kopavel/KiCadLogicalSchemeSimulator/stuff/examples/README.md

## Examples

Here is some schemas Netlist examples:

- [Clock](clock/README.md) - Simple 24h clock.
- [Counters](counters/README.md) - simple chain for counters and LEDs
- [Z80](z80/README.md) - Zilog Z80 based schema.
- [TRS80](trs80/README.md) - Stripped TRS80-I schema.
