kopavel/KiCadLogicalSchemeSimulator/stuff/examples/clock/README.md

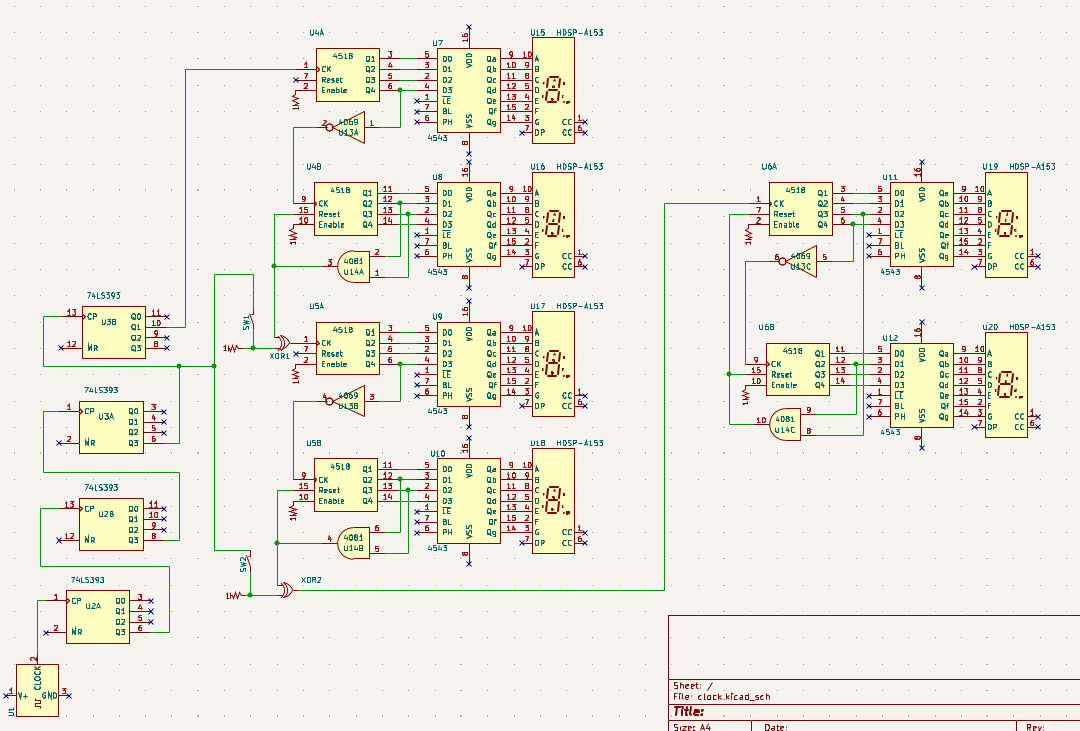
[picture p4: stuff/examples/clock/img_1.png]


**24h clock with time adjustment**

Trivial digital clock with 7 segment LED display.
Has time adjustment capability fot minutes and hours.

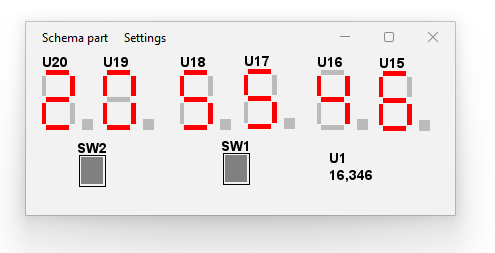
[picture p5: stuff/examples/clock/img.png]


For start use clock gradle task

```
./gradlew clock
```
