kopavel/KiCadLogicalSchemeSimulator/stuff/examples/counters/img/KiCad.png

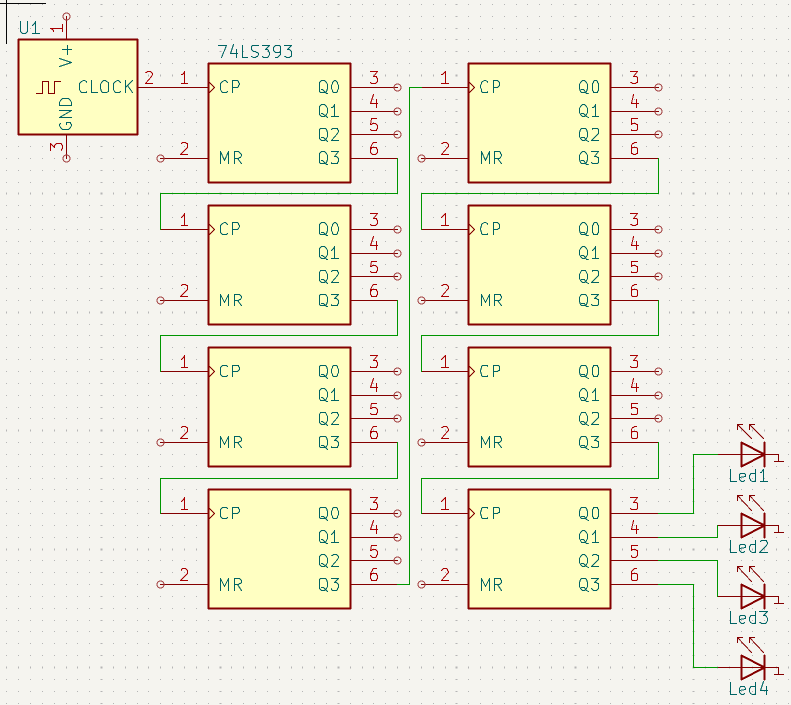
stuff/examples/counters/img/KiCad.png
