kopavel/KiCadLogicalSchemeSimulator/schemaParts/README.md

## Schema parts

For implementing or extending schema parts, see
[Schema Part Design](DESIGN_SchemaPart.md).

Some schema parts are interactive. Simulator create “representation” of that part on a “desc”.  
They can be drugged across the desk and allow you to arrange it layout to complete device look.  
Layout a stored at application exit in a file near '.net' or in KiKad project (if simulator started directly from iKiCad) with extension
`.sym_layout`.  
Some interactive parts has additional interfaces/functionality if you click on it.

* [AndGate](and/README.md) — Logical AND gate.
* [Bipolar Transistor](transistor/README.md) — Bipolar transistor.
* [Buffer](buffer/README.md) — Buffer or latch.
* [BusDriver](busDriver/README.md) — Bus driver/buffer.
* [Counter](counter/README.md) — Binary counter.
* [DCounter](dCounter/README.md) — Binary/decimal counter.
* [DcTrigger](dcTrigger/README.md) — DC-trigger with R and S inputs.
* [Decoder](decoder/README.md) — Binary decoder.
* [Diode](diode/README.md) — Diode.
* [DipSwitch](dipSwitch/README.md) — Net file filter for Dip switch behavior.
* [Display](display/README.md) — Monochrome display.
* [JkTrigger](jkTrigger/README.md) — JK trigger.
* [Keyboard](keyboard/README.md) — Matrix of key.
* [LedIndicatot](led/LedIndicator.md) — LED indicator.
* [Led](led/Led.md) — LED.
* [Led16SegmentDisplay](led16SegmentDisplay/README.md) — 16 segment LED display.
* [Led7SegmentDisplay](led7SegmentDisplay/README.md) — 7 segment LED display.
* [MaskedMultiplexer]( multiplexer/MaskedMultiplexer.md) — Multiplexer with a defined amount outputs and ways with masking inputs.
* [Mos6502](mos6502/README.md) - Mos 6502 CPU.
* [Mos6532](mos6532/README.md) - Mos 6532 RIOT.
* [MultiOutDecoder](decoder/MultiOutDecoder.md) — Decoder with multiple output pin groups.
* [MultiPartConter](counter/MultiPartCounter.md) — Multipart binary counter.
* [Multiplexer](multiplexer/README.md) — Multiplexer with a defined amount outputs and ways.
* [OrGate](or/README.md) — Logical OR gate.
* [Oscillator](oscillator/README.md) — Oscillator with various modes of operation and oscilloscope.
* [Power](power/README.md) — Static output, useful for a pull-up/pull-down resistors.
* [Ram](ram/README.md) — Static RAM.
* [Repeater](repeater/README.md) — Single bit buffer/inverter.
* [Resister](resister/README.md) — Resister.
* [RingCounter](ringCounter/README.md) — Ring counter.
* [Rom](rom/README.md) — ROM.
* [SdRam](sdram/README.md) — Dynamic RAM.
* [Shifter](shifter/README.md) — Bit shifter.
* [SingleBitBuffer](buffer/SingleBitBuffer.md) — Single bit Buffer or Latch.
* [SingleBitRam](ram/SingleBitRam.md) — Single bit Dynamic RAM.
* [SingleBitSdRam](sdram/SingleBitSdRam.md) — Single bit Dynamic RAM.
* [SingleOutShifter](shifter/SingleOutShifter.md) — Bit shifter with single bit output.
* [StateMachine](stateMachine/README.md) — Logical state machine.
* [Switch](switch/README.md) — Interactive “normally opened” switch.
* [XorGate](xor/README.md) — Logical XOR gate.
* [Z80Cpu](z80/README.md) — Zilog Z80 CPU.

* more follows …
