kopavel/KiCadLogicalSchemeSimulator/schemaParts/dipSwitch/README.md

## DipSwitch

Net file filter. Implement dip switch behavior.  
Do nothing by himself.

### Pins

#### Input names:

- none

#### Output names:

- none

### Parameters
- 

- none

#### Mandatory parameters:

- none

#### Optional parameters:

- `on` If provided - filter merge two schema nets together.
