kopavel/KiCadLogicalSchemeSimulator/schemaParts/resister/README.md

## Resister

Implements resister.

### Pins

- `IN1`, `IN2`

### Parameters

- none
