kopavel/KiCadLogicalSchemeSimulator/schemaParts/diode/README.md

## Diode

Implements diode.

### Pins

- `A`- Anode
- `K`- Cathode

### Parameters

- none
