kopavel/KiCadLogicalSchemeSimulator/schemaParts/switch/README.md

## Switch

Interactive initially opened toggle switch.

### Pins

- `IN1`,`IN2`- switch pins

### Parameters

- none
