kopavel/KiCadLogicalSchemeSimulator/schemaParts/repeater/README.md

## REPEATER

Buffer/inverter.

### Pins

#### Input names:

- `IN`- Input.

#### Output names:

- `OUT`- Output.

### Parameters

#### Mandatory parameters:

- none

#### Optional parameters:

- `reverse`- output reversed.
- `openCollector`- open collector output.
- `openEmitter`- open emitter output.

### Example

NOT element: `reverse`
