kopavel/KiCadLogicalSchemeSimulator/schemaParts/xor/README.md

## Logical XOR gate

### Pins

#### Input names:

- `IN0`, `IN1`- gate inputs.

#### Output names:

- `OUT`- Output

### Parameters

#### Mandatory parameters:

- none

#### Optional parameters:

- `reverse`- output reversed, resulting in a NXOR gate.
- `openCollector`- openCollector output

### Example

NXOR gate: `reverse`.
