kopavel/KiCadLogicalSchemeSimulator/schemaParts/or/README.md

## Logical OR gate

### Pins

#### Input names:

- `INx`- Gate input.  
  x - input number in range[0…size-1].

#### Output names:

- `OUT`- Gate output.

### Parameters

#### Mandatory parameters:

- `size`- amount of input pin in range[2…32].

#### Optional parameters:

- `reverse`- reverse output for NOR gate.
- `openColector`- openCollector output

### Example

2-input NOR gate: `size=2;reverse`
