kopavel/KiCadLogicalSchemeSimulator/stuff/examples/counters/img/result.png

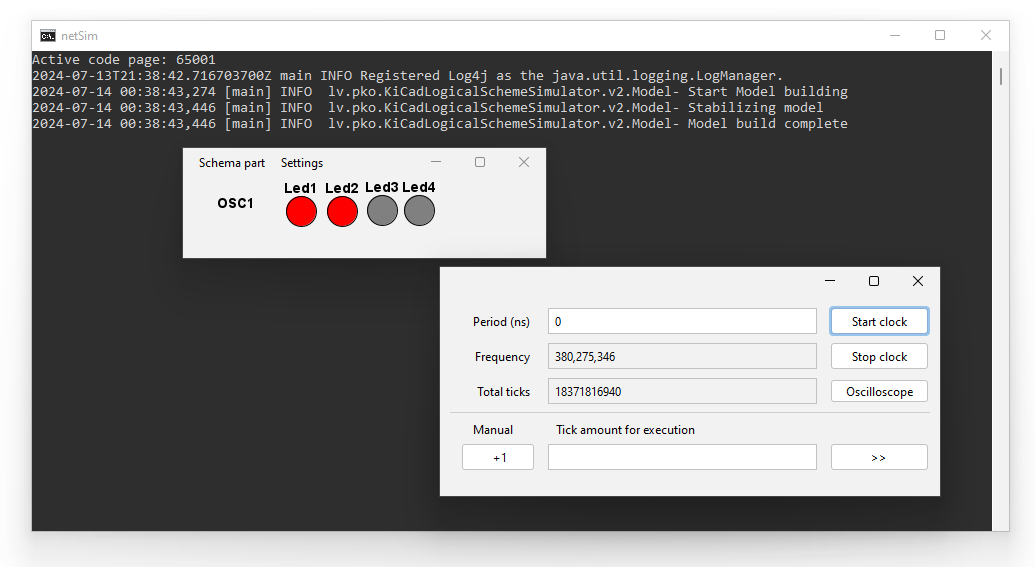
stuff/examples/counters/img/result.png
