kopavel/KiCadLogicalSchemeSimulator/stuff/examples/clock/clock.kicad_sch

## KiCad design stuff/examples/clock/clock.kicad_sch (2025-03-15)

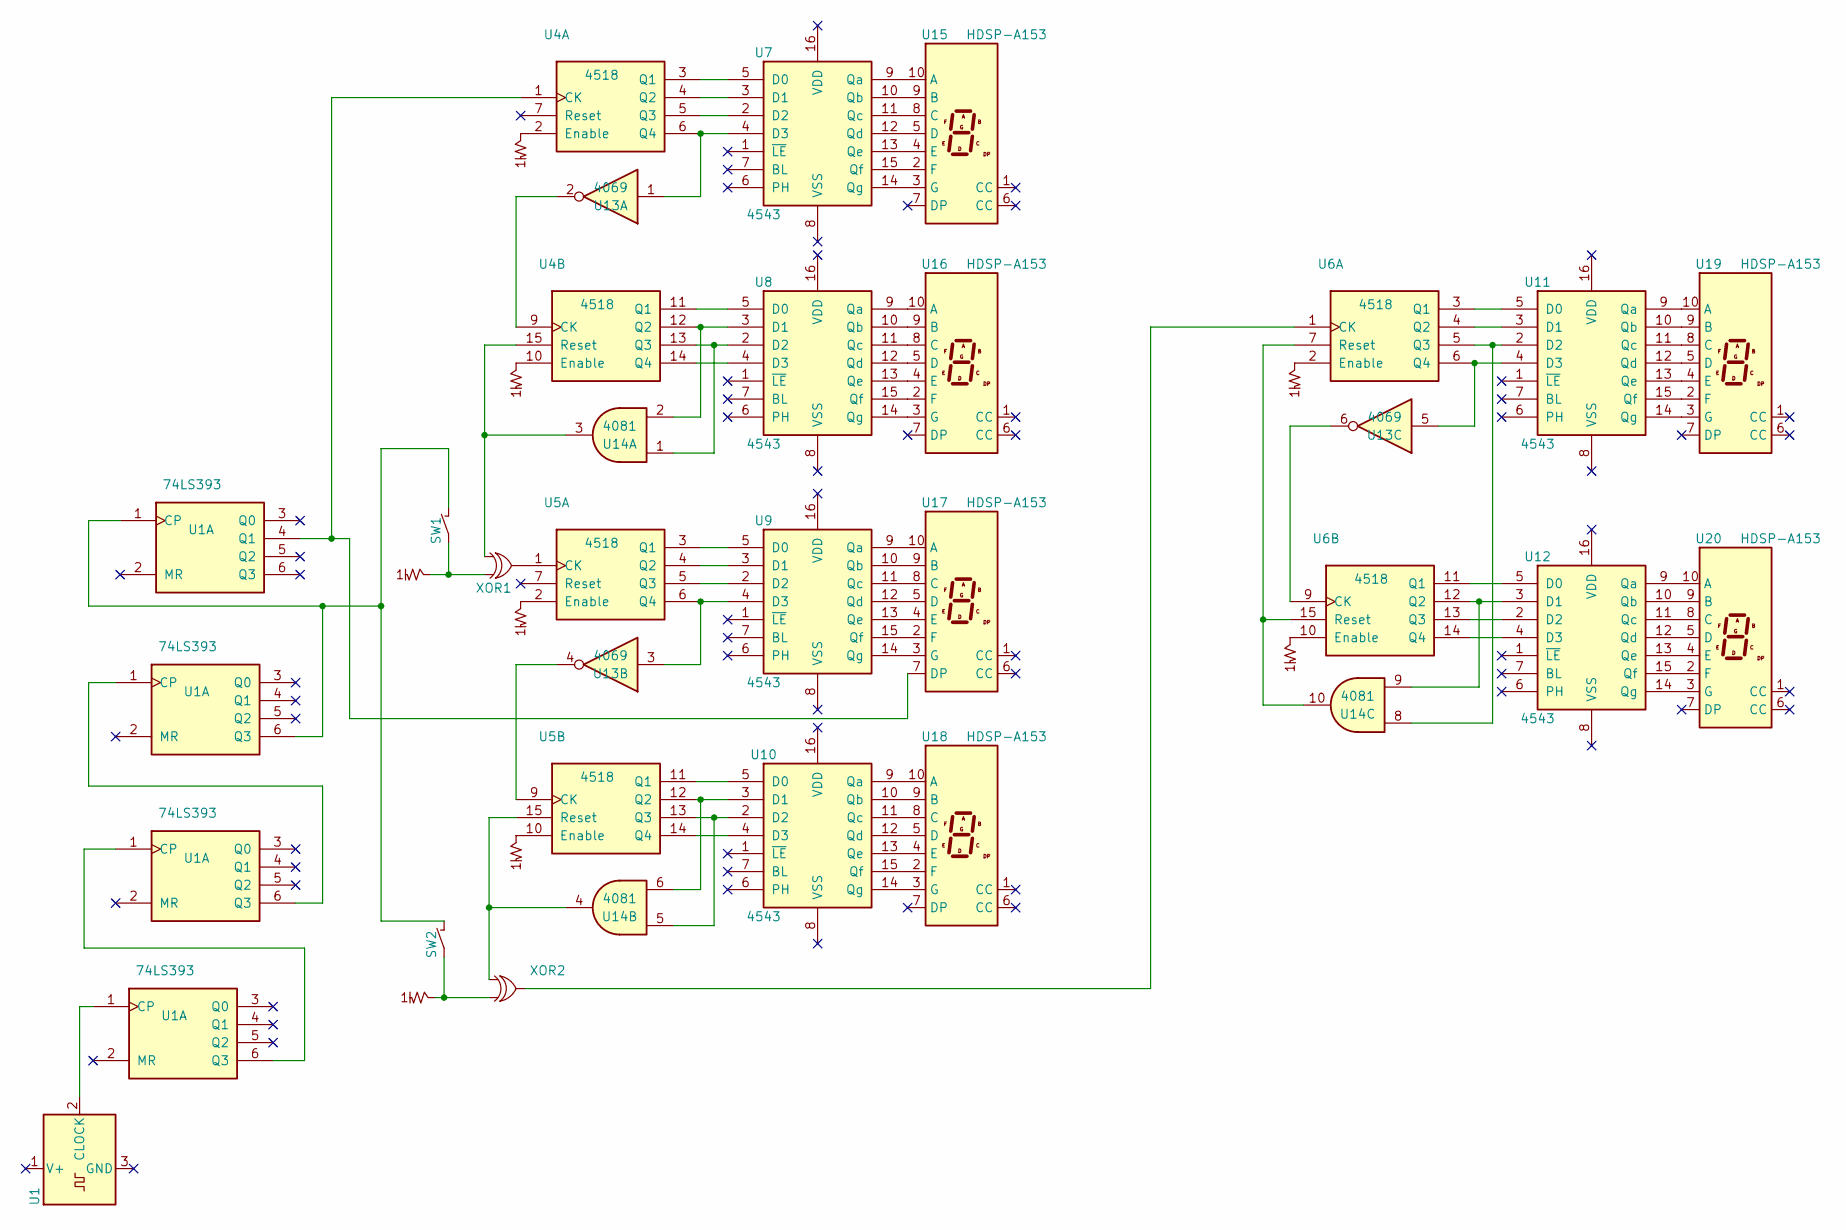
[picture p14: schematic clock.kicad_sch]

Parts:
SW1, SW2: SWITCH; SW_CW_GPTS203211B
U1: 74LS393; DIP-14_W7.62mm
U4, U5, U6: 4518
U7, U8, U9, U10, U11, U12: 4543
U13: 4069
U14: 4081
U15, U16, U17, U18, U19, U20: HDSP-A153; HDSP-A151
XOR1, XOR2: XOR
pullup1, pullup2, pullup3, pullup4, pullup5, pullup6, pullup7, pullup8: pull_up

Connections:
unnamed: SW1.1 (IN1), XOR1.2 (IN1), pullup1.1
unnamed: SW1.2 (IN2), SW2.2 (IN2), U1.1 (V+), U1.6 (Q3)
unnamed: SW2.1 (IN1), XOR2.2 (IN1), pullup2.1
unnamed: U1.1 (V+), U1.2 (CLOCK), U1.6 (Q3)
unnamed: U1.4 (Q1), U4.1 (CK), U17.7 (DP)
unnamed: U4.2 (Enable), pullup5.1
unnamed: U4.3 (Q1), U7.5 (D0)
unnamed: U4.4 (Q2), U7.3 (D1)
unnamed: U4.5 (Q3), U7.2 (D2)
unnamed: U4.10 (Enable), pullup3.1
unnamed: U4.11 (Q1), U8.5 (D0)
unnamed: U4.14 (Q4), U8.4 (D3)
unnamed: U5.1 (CK), XOR1.3 (OUT)
unnamed: U5.2 (Enable), pullup6.1
unnamed: U5.3 (Q1), U9.5 (D0)
unnamed: U5.4 (Q2), U9.3 (D1)
unnamed: U5.5 (Q3), U9.2 (D2)
unnamed: U5.10 (Enable), pullup4.1
unnamed: U6.1 (CK), XOR2.3 (OUT)
unnamed: U6.2 (Enable), pullup8.1
unnamed: U6.10 (Enable), pullup7.1
unnamed: U5.13 (Q3), U10.2 (D2), U14.5
unnamed: U5.12 (Q2), U10.3 (D1), U14.6
unnamed: U5.14 (Q4), U10.4 (D3)
unnamed: U5.11 (Q1), U10.5 (D0)
unnamed: U10.9 (Qa), U18.10 (A)
unnamed: U10.10 (Qb), U18.9 (B)
unnamed: U10.11 (Qc), U18.8 (C)
unnamed: U10.12 (Qd), U18.5 (D)
unnamed: U10.13 (Qe), U18.4 (E)
unnamed: U10.14 (Qg), U18.3 (G)
unnamed: U10.15 (Qf), U18.2 (F)
unnamed: U6.5 (Q3), U11.2 (D2), U14.8
unnamed: U6.4 (Q2), U11.3 (D1)
unnamed: U6.6 (Q4), U11.4 (D3), U13.5
unnamed: U6.3 (Q1), U11.5 (D0)
unnamed: U11.9 (Qa), U19.10 (A)
unnamed: U11.10 (Qb), U19.9 (B)
unnamed: U11.11 (Qc), U19.8 (C)
unnamed: U11.12 (Qd), U19.5 (D)
unnamed: U11.13 (Qe), U19.4 (E)
unnamed: U11.14 (Qg), U19.3 (G)
unnamed: U11.15 (Qf), U19.2 (F)
unnamed: U6.13 (Q3), U12.2 (D2)
unnamed: U6.12 (Q2), U12.3 (D1), U14.9
unnamed: U6.14 (Q4), U12.4 (D3)
unnamed: U6.11 (Q1), U12.5 (D0)
unnamed: U12.9 (Qa), U20.10 (A)
unnamed: U12.10 (Qb), U20.9 (B)
unnamed: U12.11 (Qc), U20.8 (C)
unnamed: U12.12 (Qd), U20.5 (D)
unnamed: U12.13 (Qe), U20.4 (E)
unnamed: U12.14 (Qg), U20.3 (G)
unnamed: U12.15 (Qf), U20.2 (F)
unnamed: U4.6 (Q4), U7.4 (D3), U13.1
unnamed: U4.9 (CK), U13.2
unnamed: U5.6 (Q4), U9.4 (D3), U13.3
unnamed: U5.9 (CK), U13.4
unnamed: U6.9 (CK), U13.6
unnamed: U4.13 (Q3), U8.2 (D2), U14.1
unnamed: U4.12 (Q2), U8.3 (D1), U14.2
unnamed: U4.15 (Reset), U14.3, XOR1.1 (IN0)
unnamed: U5.15 (Reset), U14.4, XOR2.1 (IN0)
unnamed: U6.7 (Reset), U6.15 (Reset), U14.10
unnamed: U7.15 (Qf), U15.2 (F)
unnamed: U7.14 (Qg), U15.3 (G)
unnamed: U7.13 (Qe), U15.4 (E)
unnamed: U7.12 (Qd), U15.5 (D)
unnamed: U7.11 (Qc), U15.8 (C)
unnamed: U7.10 (Qb), U15.9 (B)
unnamed: U7.9 (Qa), U15.10 (A)
unnamed: U8.15 (Qf), U16.2 (F)
unnamed: U8.14 (Qg), U16.3 (G)
unnamed: U8.13 (Qe), U16.4 (E)
unnamed: U8.12 (Qd), U16.5 (D)
unnamed: U8.11 (Qc), U16.8 (C)
unnamed: U8.10 (Qb), U16.9 (B)
unnamed: U8.9 (Qa), U16.10 (A)
unnamed: U9.15 (Qf), U17.2 (F)
unnamed: U9.14 (Qg), U17.3 (G)
unnamed: U9.13 (Qe), U17.4 (E)
unnamed: U9.12 (Qd), U17.5 (D)
unnamed: U9.11 (Qc), U17.8 (C)
unnamed: U9.10 (Qb), U17.9 (B)
unnamed: U9.9 (Qa), U17.10 (A)
