kopavel/KiCadLogicalSchemeSimulator/stuff/examples/counters/counters.kicad_sch

## KiCad design stuff/examples/counters/counters.kicad_sch (2025-03-15)

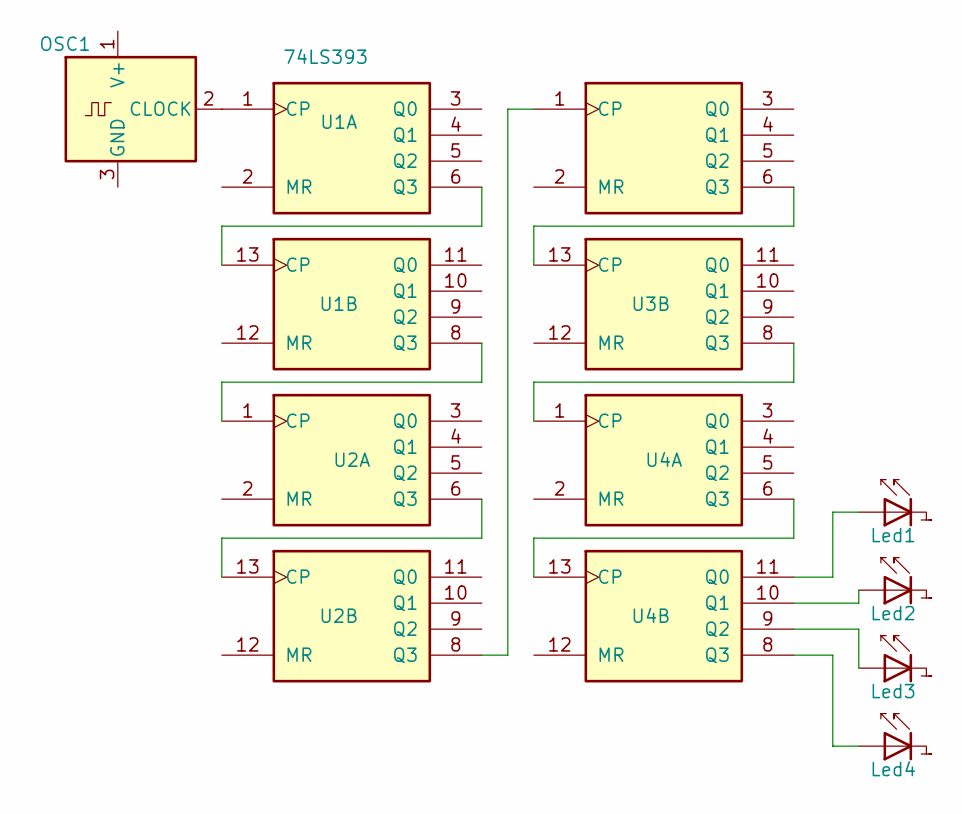
[picture p15: schematic counters.kicad_sch]

Parts:
Led1, Led2, Led3, Led4: LED_D5.0mm_Horizontal_O1.27mm_Z3.0mm_IRGrey
OSC1: MAX7375AXR805; SOT-323_SC-70
U1, U2, U3, U4: 74LS393; DIP-14_W7.62mm

Connections:
unnamed: Led1.1, U4.11 (Q0)
unnamed: Led2.1, U4.10 (Q1)
unnamed: Led3.1, U4.9 (Q2)
unnamed: Led4.1, U4.8 (Q3)
unnamed: OSC1.2 (CLOCK), U1.1 (CP)
unnamed: U1.8 (Q3), U2.1 (CP)
unnamed: U1.6 (Q3), U1.13 (CP)
unnamed: U2.8 (Q3), U3.1 (CP)
unnamed: U2.6 (Q3), U2.13 (CP)
unnamed: U3.8 (Q3), U4.1 (CP)
unnamed: U3.6 (Q3), U3.13 (CP)
unnamed: U4.6 (Q3), U4.13 (CP)
