kopavel/KiCadLogicalSchemeSimulator/stuff/examples/diode/diode.kicad_sch

## KiCad design stuff/examples/diode/diode.kicad_sch (2024-08-30)

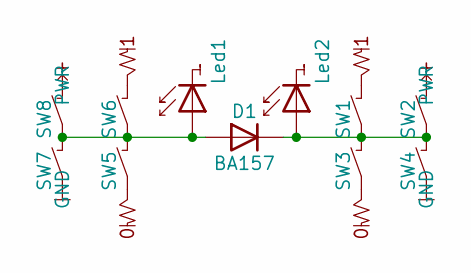
[picture p16: schematic diode.kicad_sch]

Parts:
D1: BA157; D_DO-41_SOD81_P10.16mm_Horizontal
Led1, Led2: (no value)
SW1, SW2, SW3, SW4, SW5, SW6, SW7, SW8: SWITCH; SW_CW_GPTS203211B
pulldown1, pulldown2: pull_down
pullup1, pullup2: pull_up

Connections:
GND: SW4.1 (IN1), SW7.1 (IN1)
unnamed: D1.1 (K), Led2.1, SW1.1 (IN1), SW2.1 (IN1), SW3.2 (IN2), SW4.2 (IN2)
unnamed: D1.2 (A), Led1.1, SW5.2 (IN2), SW6.1 (IN1), SW7.2 (IN2), SW8.1 (IN1)
unnamed: SW1.2 (IN2), pullup2.1
unnamed: SW3.1 (IN1), pulldown2.1
unnamed: SW5.1 (IN1), pulldown1.1
unnamed: SW6.2 (IN2), pullup1.1
PWR: SW2.2 (IN2), SW8.2 (IN2)
