kopavel/KiCadLogicalSchemeSimulator/stuff/examples/diode/diodes.kicad_sch

## KiCad design stuff/examples/diode/diodes.kicad_sch (2026-06-10)

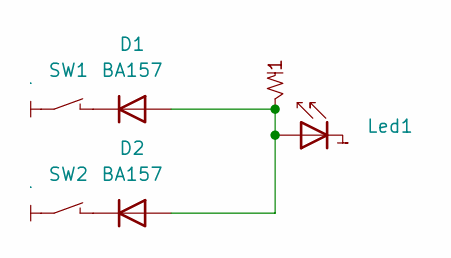
[picture p17: schematic diodes.kicad_sch]

Parts:
D1, D2: BA157; D_DO-41_SOD81_P10.16mm_Horizontal
GND01, GND02: GND
Led1: (no value)
SW1, SW2: SWITCH; SW_CW_GPTS203211B
pullup1: pull_up

Connections:
unnamed: D1.1 (K), SW1.2 (IN2)
unnamed: D1.2 (A), D2.2 (A), Led1.1, pullup1.1
unnamed: D2.1 (K), SW2.2 (IN2)
unnamed: GND01.1, SW1.1 (IN1)
unnamed: GND02.1, SW2.1 (IN1)
