kopavel/KiCadLogicalSchemeSimulator/stuff/examples/dipSwitch/dipSwitch.kicad_sch

## KiCad design stuff/examples/dipSwitch/dipSwitch.kicad_sch (2025-03-23)

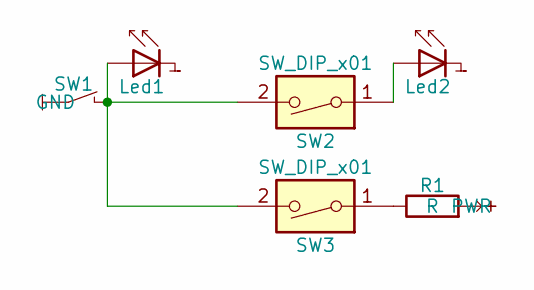
[picture p18: schematic dipSwitch.kicad_sch]

Parts:
Led1, Led2: (no value)
R1: R
SW1: SWITCH; SW_CW_GPTS203211B
SW2, SW3: SW_DIP_x01

Connections:
GND: SW1.1 (IN1)
unnamed: Led1.1, SW1.2 (IN2), SW2.2, SW3.2
unnamed: Led2.1, SW2.1
unnamed: R1.1, SW3.1
PWR: R1.2
