kopavel/KiCadLogicalSchemeSimulator/stuff/examples/filters/filters.kicad_sch

## KiCad design stuff/examples/filters/filters.kicad_sch (2026-04-16)

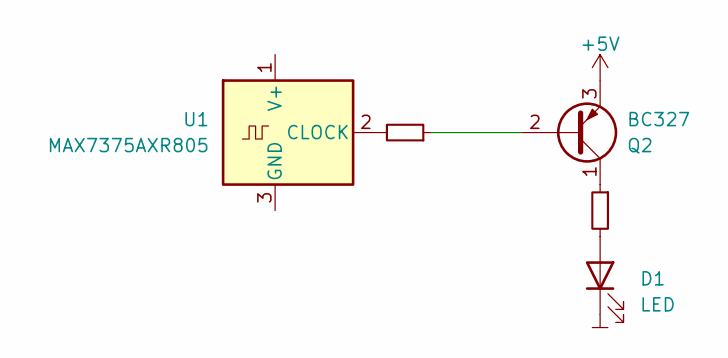
[picture p19: schematic filters.kicad_sch]

Parts:
D1: LED
Q2: BC327; TO-92_Inline
R1, R6: 100R; R_Axial_DIN0309_100R_L6.3mm_D2.5mm_P12.70mm_Horizontal
U1: MAX7375AXR805; SOT-323_SC-70

Connections:
+5V: Q2.3 (E)
GND: D1.1 (K)
unnamed: D1.2 (A), R1.2
unnamed: Q2.1 (C), R1.1
unnamed: Q2.2 (B), R6.1
unnamed: R6.2, U1.2 (CLOCK)
