kopavel/KiCadLogicalSchemeSimulator/stuff/examples/mos6502/mos6502.kicad_sch

## KiCad design stuff/examples/mos6502/mos6502.kicad_sch (2025-04-13)

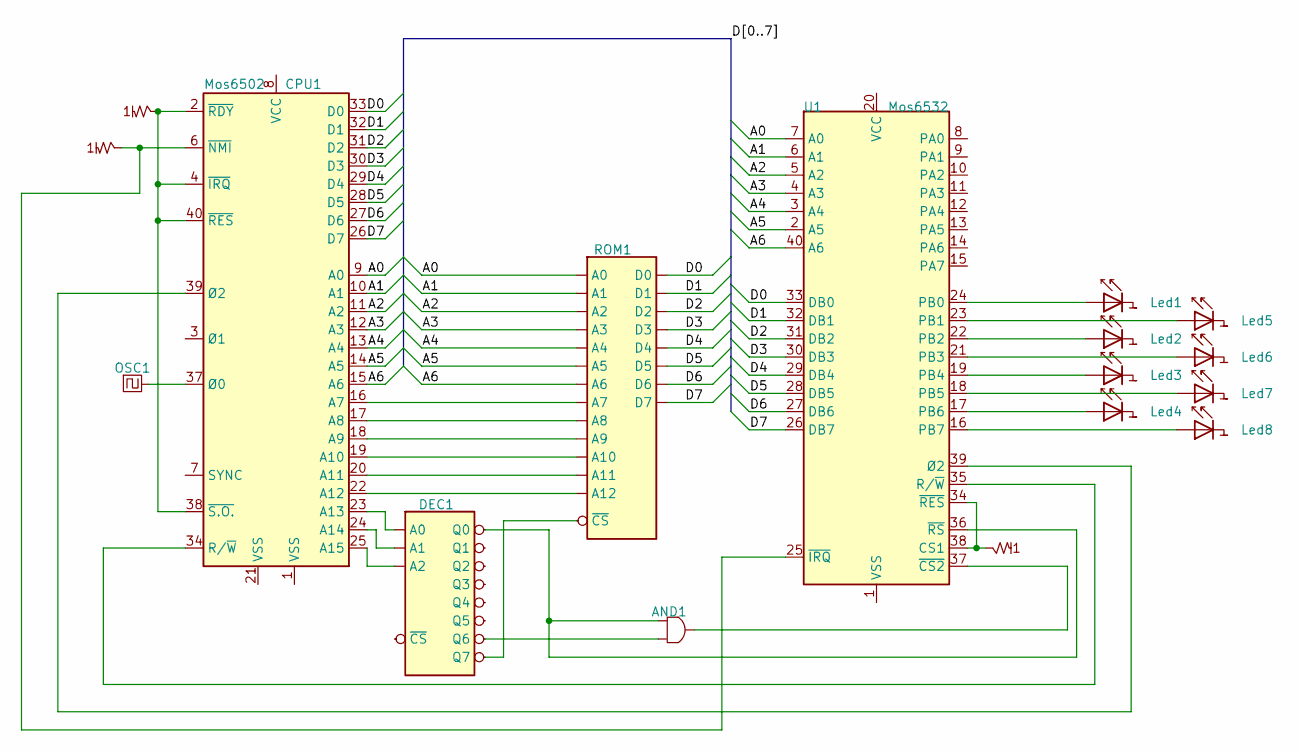
[picture p20: schematic mos6502.kicad_sch]

Parts:
AND1: AND
CPU1: Mos6502; DIP-40_W15.24mm
DEC1: decode_3_bit
Led1, Led2, Led3, Led4, Led5, Led6, Led7, Led8: (no value)
OSC1: OSC
ROM1: ROM
U1: Mos6532; DIP-40_W15.24mm
pullup1, pullup2, pullup3: pull_up

Connections:
A0: CPU1.9 (A0), ROM1.1 (A0), U1.7 (A0)
A1: CPU1.10 (A1), ROM1.2 (A1), U1.6 (A1)
A2: CPU1.11 (A2), ROM1.6 (A2), U1.5 (A2)
A3: CPU1.12 (A3), ROM1.7 (A3), U1.4 (A3)
A4: CPU1.13 (A4), ROM1.8 (A4), U1.3 (A4)
A5: CPU1.14 (A5), ROM1.9 (A5), U1.2 (A5)
A6: CPU1.15 (A6), ROM1.10 (A6), U1.40 (A6)
D0: CPU1.33 (D0), ROM1.14 (D0), U1.33 (DB0)
D1: CPU1.32 (D1), ROM1.15 (D1), U1.32 (DB1)
D2: CPU1.31 (D2), ROM1.16 (D2), U1.31 (DB2)
D3: CPU1.30 (D3), ROM1.17 (D3), U1.30 (DB3)
D4: CPU1.29 (D4), ROM1.18 (D4), U1.29 (DB4)
D5: CPU1.28 (D5), ROM1.19 (D5), U1.28 (DB5)
D6: CPU1.27 (D6), ROM1.20 (D6), U1.27 (DB6)
D7: CPU1.26 (D7), ROM1.21 (D7), U1.26 (DB7)
unnamed: AND1.1 (IN0), DEC1.4 (Q0), U1.36 (~RS)
unnamed: AND1.2 (IN1), DEC1.10 (Q6)
unnamed: AND1.3 (OUT), U1.37 (~CS2)
unnamed: CPU1.2 (~RDY), CPU1.4 (~IRQ), CPU1.38 (~S.O.), CPU1.40 (~RES), pullup1.1
unnamed: CPU1.6 (~NMI), U1.25 (~IRQ), pullup3.1
unnamed: CPU1.16 (A7), ROM1.11 (A7)
unnamed: CPU1.17 (A8), ROM1.12 (A8)
unnamed: CPU1.18 (A9), ROM1.13 (A9)
unnamed: CPU1.19 (A10), ROM1.3 (A10)
unnamed: CPU1.20 (A11), ROM1.4 (A11)
unnamed: CPU1.22 (A12), ROM1.5 (A12)
unnamed: CPU1.23 (A13), DEC1.1 (A0)
unnamed: CPU1.24 (A14), DEC1.2 (A1)
unnamed: CPU1.25 (A15), DEC1.3 (A2)
unnamed: CPU1.34 (R/~W), U1.35 (R/~W)
unnamed: CPU1.37 (Ø0), OSC1.1
unnamed: CPU1.39 (Ø2), U1.39 (Ø2)
unnamed: DEC1.11 (Q7), ROM1.22 (~CS)
unnamed: Led1.1, U1.24 (PB0)
unnamed: Led2.1, U1.22 (PB2)
unnamed: Led3.1, U1.19 (PB4)
unnamed: Led4.1, U1.17 (PB6)
unnamed: Led5.1, U1.23 (PB1)
unnamed: Led6.1, U1.21 (PB3)
unnamed: Led7.1, U1.18 (PB5)
unnamed: Led8.1, U1.16 (PB7)
unnamed: U1.34 (~RES), U1.38 (CS1), pullup2.1
