kopavel/KiCadLogicalSchemeSimulator/stuff/examples/resisterFilter/resister.kicad_sch

## KiCad design stuff/examples/resisterFilter/resister.kicad_sch (2025-03-16)

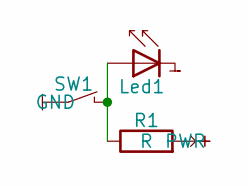
[picture p21: schematic resister.kicad_sch]

Parts:
Led1: (no value)
PWR01: PWR
R1: R
SW1: SWITCH; SW_CW_GPTS203211B

Connections:
GND: SW1.1 (IN1)
unnamed: Led1.1, R1.1, SW1.2 (IN2)
unnamed: PWR01.1, R1.2
