kopavel/KiCadLogicalSchemeSimulator/stuff/examples/switch/switch.kicad_sch

## KiCad design stuff/examples/switch/switch.kicad_sch (2024-08-05)

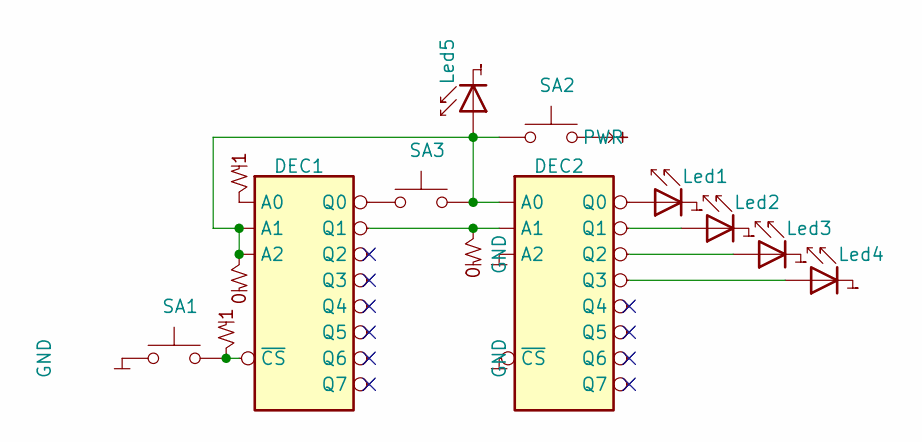
[picture p22: schematic switch.kicad_sch]

Parts:
DEC1, DEC2: decode_3_bit
Led1, Led2, Led3, Led4, Led5: (no value)
SA1, SA2, SA3: SW_Push
pulldown1, pulldown2: pull_down
pullup1, pullup2: pull_up

Connections:
GND: DEC2.3 (A2), DEC2.12 (~CS), SA1.1
unnamed: DEC1.1 (A0), pullup1.1
unnamed: DEC1.2 (A1), DEC1.3 (A2), DEC2.1 (A0), Led5.1, SA2.1, SA3.2, pulldown1.1
unnamed: DEC1.4 (Q0), SA3.1
unnamed: DEC1.5 (Q1), DEC2.2 (A1), pulldown2.1
unnamed: DEC1.12 (~CS), SA1.2, pullup2.1
unnamed: DEC2.4 (Q0), Led1.1
unnamed: DEC2.5 (Q1), Led2.1
unnamed: DEC2.6 (Q2), Led3.1
unnamed: DEC2.7 (Q3), Led4.1
PWR: SA2.2
