kopavel/KiCadLogicalSchemeSimulator/stuff/examples/trs80/TRS80I.kicad_sch

## KiCad design stuff/examples/trs80/TRS80I.kicad_sch (2025-03-26)

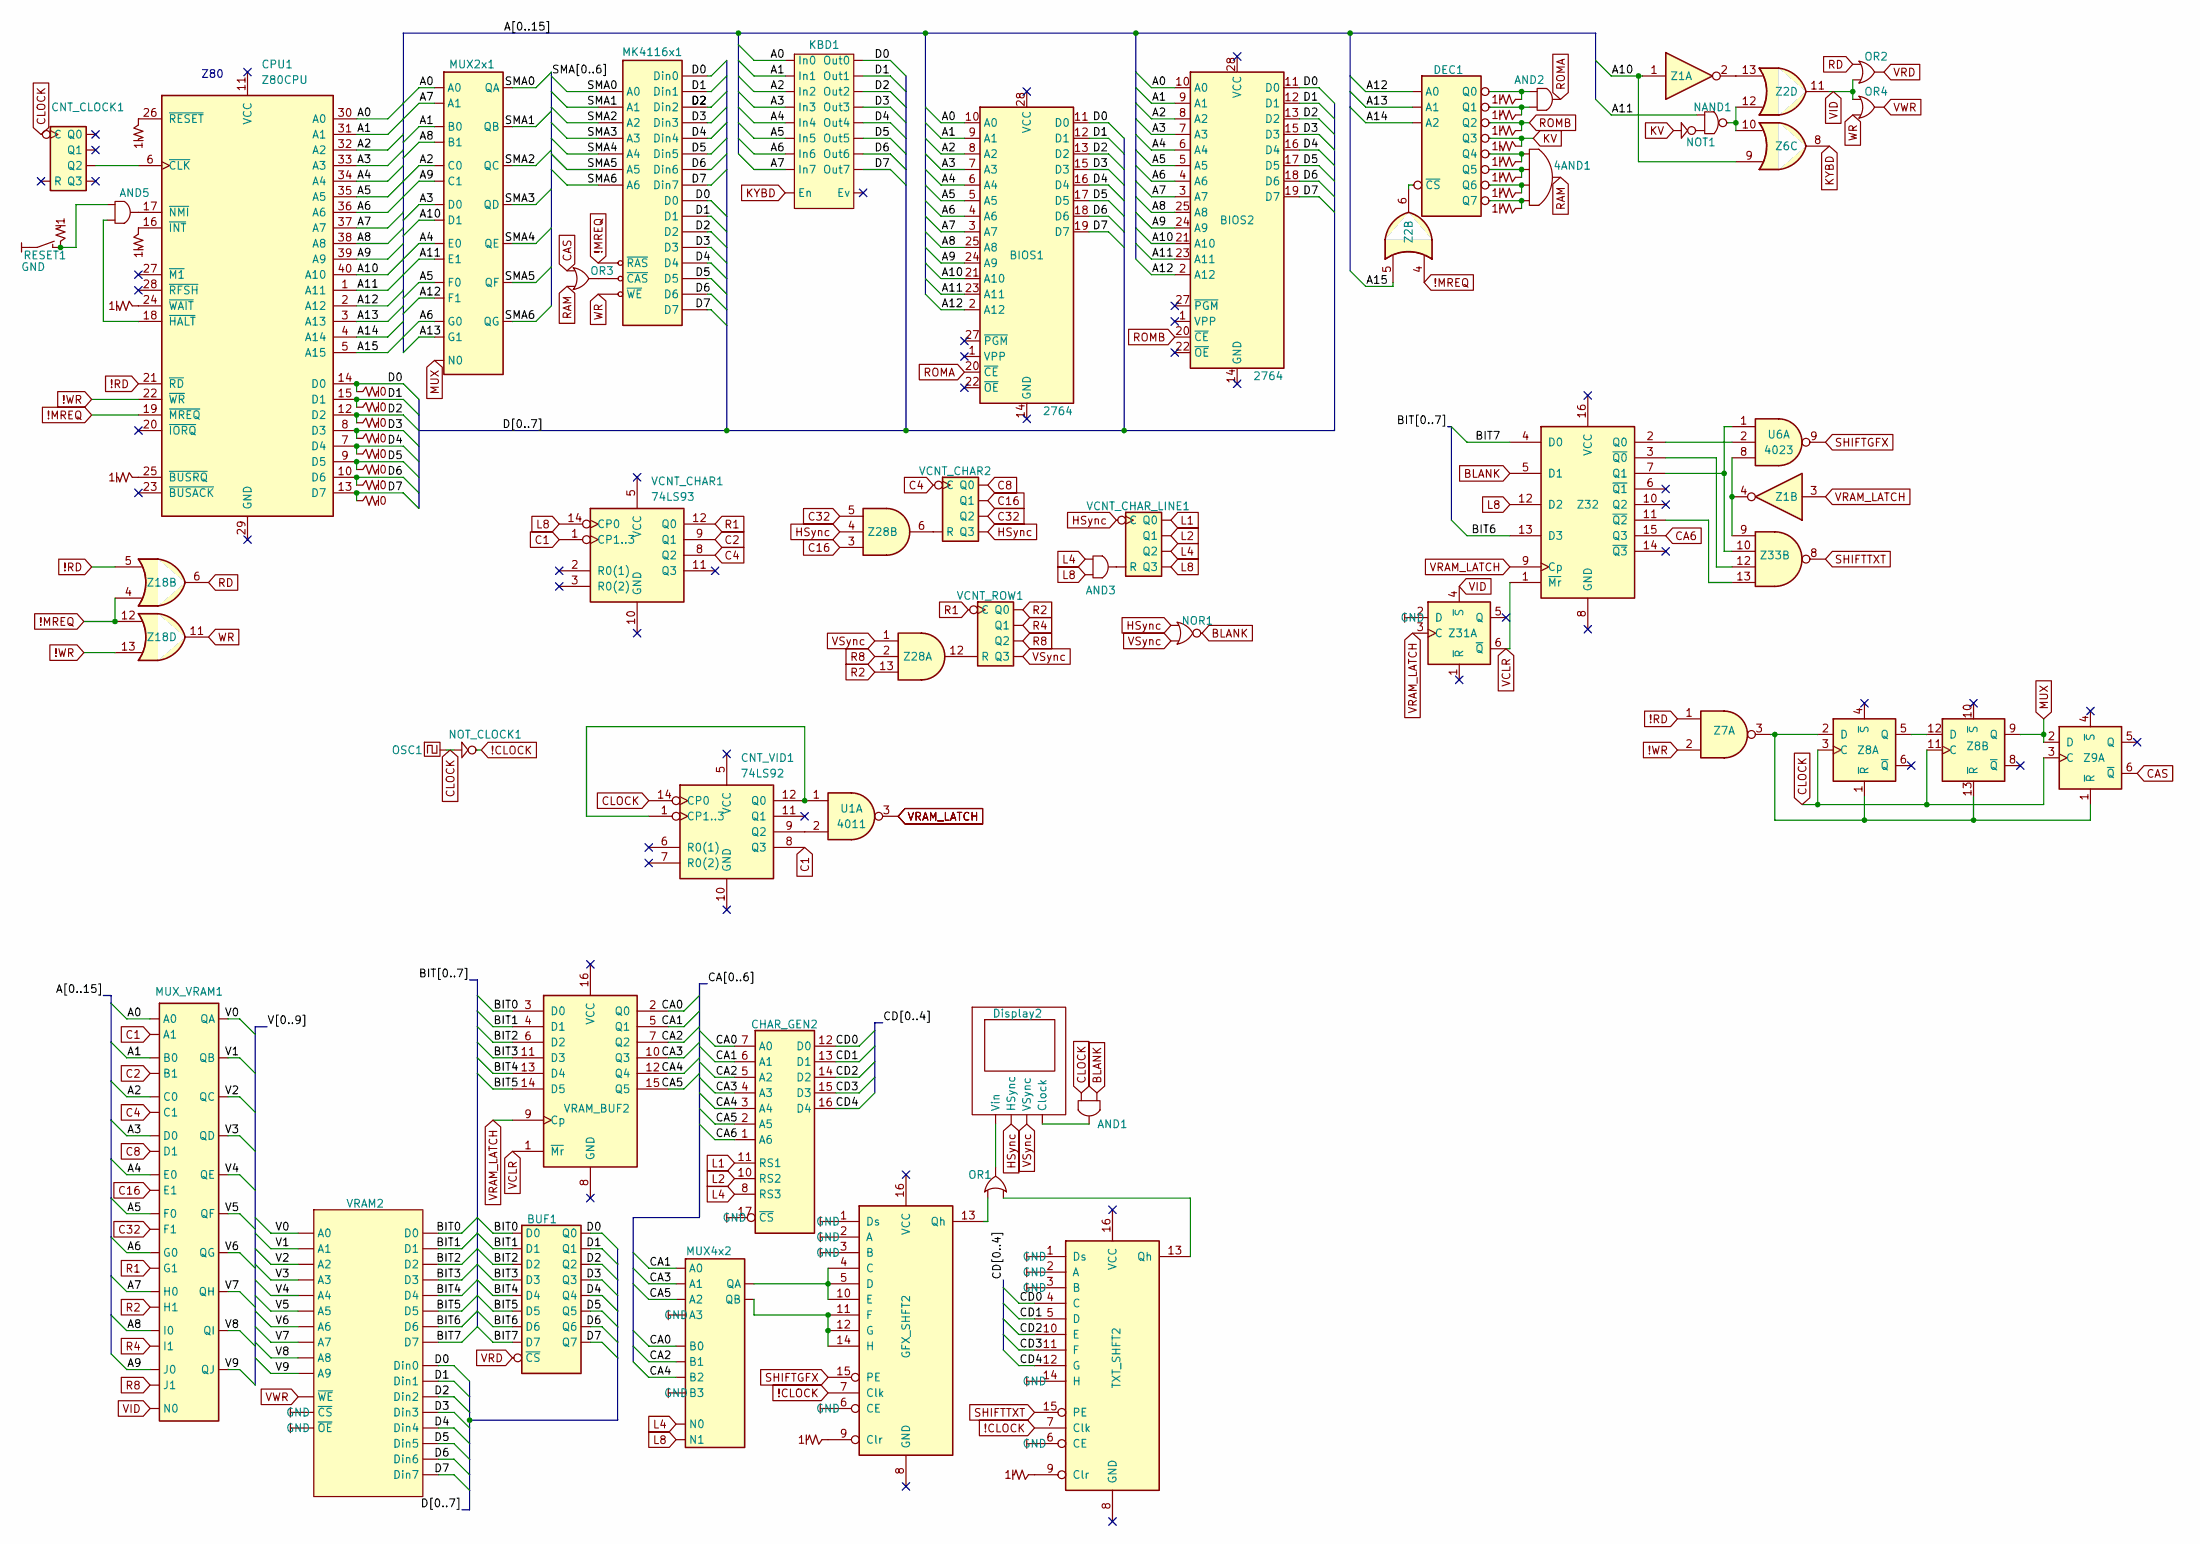
[picture p23: schematic TRS80I.kicad_sch]

Parts:
4AND1: AND
AND1, AND2, AND3, AND5: AND
BIOS1, BIOS2: 2764; DIP-28_W15.24mm
BUF1: BUF
CHAR_GEN2: MCM6670
CNT_CLOCK1: CNT
CNT_VID1: 74LS92; DIP-14_W7.62mm
CPU1: Z80CPU; DIP-40_W15.24mm
DEC1: decode_3_bit
Display2: (no value)
GFX_SHFT2: 74LS166; DIP-16_W7.62mm
KBD1: (no value)
MK4116x1: MK4116x8
MUX2x1: MUX2x7
MUX4x2: MUX
MUX_VRAM1: MUX2x10
NAND1: NAND
NOR1: NOR
NOT1: NOT
NOT_CLOCK1: NOT
OR1, OR2, OR3, OR4: OR
OSC1: OSC
RESET1: SWITCH; SW_CW_GPTS203211B
TXT_SHFT2: 74LS166; DIP-16_W7.62mm
U1: 4011
U6: 4023
VCNT_CHAR1: 74LS93; DIP-14_W7.62mm
VCNT_CHAR2: CNT
VCNT_CHAR_LINE1: CNT
VCNT_ROW1: CNT
VRAM2: (no value)
VRAM_BUF2: 74LS174; DIP-16_W7.62mm
Z1: 74LS04; DIP-14_W7.62mm
Z2, Z6, Z18: 74LS32; DIP-14_W7.62mm
Z7: 74LS00; DIP-14_W7.62mm
Z8, Z9, Z31: 74LS74; DIP-14_W7.62mm
Z28: 74LS11; DIP-14_W7.62mm
Z32: 74LS175; DIP-16_W7.62mm
Z33: 74LS20; DIP-14_W7.62mm
pulldown1, pulldown2, pulldown3, pulldown4, pulldown5, pulldown6, pulldown7, pulldown8: pull_down
pullup1, pullup2, pullup3, pullup4, pullup5, pullup6, pullup7, pullup8, pullup11, pullup19, pullup20, pullup21, pullup22, pullup28, pullup29: pull_up

Connections:
!CLOCK: GFX_SHFT2.7 (Clk), NOT_CLOCK1.1 (OUT), TXT_SHFT2.7 (Clk)
!MREQ: CPU1.19 (~MREQ), MK4116x1.10 (~RAS), Z2.4, Z18.4, Z18.12
!RD: CPU1.21 (~RD), Z7.1, Z18.5
!WR: CPU1.22 (~WR), Z7.2, Z18.13
A0: BIOS1.10 (A0), BIOS2.10 (A0), CPU1.30 (A0), KBD1.2 (In0), MUX2x1.2 (A0), MUX_VRAM1.1 (A0)
A1: BIOS1.9 (A1), BIOS2.9 (A1), CPU1.31 (A1), KBD1.4 (In1), MUX2x1.8 (B0), MUX_VRAM1.3 (B0)
A2: BIOS1.8 (A2), BIOS2.8 (A2), CPU1.32 (A2), KBD1.6 (In2), MUX2x1.18 (C0), MUX_VRAM1.5 (C0)
A3: BIOS1.7 (A3), BIOS2.7 (A3), CPU1.33 (A3), KBD1.8 (In3), MUX2x1.24 (D0), MUX_VRAM1.7 (D0)
A4: BIOS1.6 (A4), BIOS2.6 (A4), CPU1.34 (A4), KBD1.10 (In4), MUX2x1.3 (E0), MUX_VRAM1.10 (E0)
A5: BIOS1.5 (A5), BIOS2.5 (A5), CPU1.35 (A5), KBD1.12 (In5), MUX2x1.9 (F0), MUX_VRAM1.14 (F0)
A6: BIOS1.4 (A6), BIOS2.4 (A6), CPU1.36 (A6), KBD1.15 (In6), MUX2x1.19 (G0), MUX_VRAM1.18 (G0)
A7: BIOS1.3 (A7), BIOS2.3 (A7), CPU1.37 (A7), KBD1.17 (In7), MUX2x1.4 (A1), MUX_VRAM1.22 (H0)
A8: BIOS1.25 (A8), BIOS2.25 (A8), CPU1.38 (A8), MUX2x1.10 (B1), MUX_VRAM1.9 (I0)
A9: BIOS1.24 (A9), BIOS2.24 (A9), CPU1.39 (A9), MUX2x1.16 (C1), MUX_VRAM1.13 (J0)
A10: BIOS1.21 (A10), BIOS2.21 (A10), CPU1.40 (A10), MUX2x1.22 (D1), Z1.1, Z6.9
A11: BIOS1.23 (A11), BIOS2.23 (A11), CPU1.1 (A11), MUX2x1.5 (E1), NAND1.1 (IN0)
A12: BIOS1.2 (A12), BIOS2.2 (A12), CPU1.2 (A12), DEC1.1 (A0), MUX2x1.11 (F1)
A13: CPU1.3 (A13), DEC1.2 (A1), MUX2x1.17 (G1)
A14: CPU1.4 (A14), DEC1.3 (A2)
A15: CPU1.5 (A15), Z2.5
BIT0: BUF1.1 (D0), VRAM2., VRAM_BUF2.3 (D0)
BIT1: BUF1.2 (D1), VRAM2., VRAM_BUF2.4 (D1)
BIT2: BUF1.3 (D2), VRAM2., VRAM_BUF2.6 (D2)
BIT3: BUF1.4 (D3), VRAM2., VRAM_BUF2.11 (D3)
BIT4: BUF1.5 (D4), VRAM2., VRAM_BUF2.13 (D4)
BIT5: BUF1.6 (D5), VRAM2., VRAM_BUF2.14 (D5)
BIT6: BUF1.7 (D6), VRAM2., Z32.13 (D3)
BIT7: BUF1.8 (D7), VRAM2., Z32.4 (D0)
BLANK: AND1.2 (IN1), NOR1.3 (OUT), Z32.5 (D1)
C1: CNT_VID1.8 (Q3), MUX_VRAM1.2 (A1), VCNT_CHAR1.1 (CP1..3)
C2: MUX_VRAM1.4 (B1), VCNT_CHAR1.9 (Q1)
C4: MUX_VRAM1.6 (C1), VCNT_CHAR1.8 (Q2), VCNT_CHAR2.1 (C)
C8: MUX_VRAM1.8 (D1), VCNT_CHAR2.2 (Q0)
C16: MUX_VRAM1.12 (E1), VCNT_CHAR2.3 (Q1), Z28.3
C32: MUX_VRAM1.16 (F1), VCNT_CHAR2.4 (Q2), Z28.5
CA0: CHAR_GEN2.7 (A0), MUX4x2.7 (B0), VRAM_BUF2.2 (Q0)
CA1: CHAR_GEN2.6 (A1), MUX4x2.3 (A0), VRAM_BUF2.5 (Q1)
CA2: CHAR_GEN2.5 (A2), MUX4x2.8 (B1), VRAM_BUF2.7 (Q2)
CA3: CHAR_GEN2.4 (A3), MUX4x2.4 (A1), VRAM_BUF2.10 (Q3)
CA4: CHAR_GEN2.3 (A4), MUX4x2.9 (B2), VRAM_BUF2.12 (Q4)
CA5: CHAR_GEN2.2 (A5), MUX4x2.5 (A2), VRAM_BUF2.15 (Q5)
CA6: CHAR_GEN2.1 (A6), Z32.15 (Q3)
CAS: OR3.1 (IN0), Z9.6 (~Q)
CD0: CHAR_GEN2.12 (D0), TXT_SHFT2.4 (C)
CD1: CHAR_GEN2.13 (D1), TXT_SHFT2.5 (D)
CD2: CHAR_GEN2.14 (D2), TXT_SHFT2.10 (E)
CD3: CHAR_GEN2.15 (D3), TXT_SHFT2.11 (F)
CD4: CHAR_GEN2.16 (D4), TXT_SHFT2.12 (G)
CLOCK: AND1.1 (IN0), CNT_CLOCK1.1 (C), CNT_VID1.14 (CP0), NOT_CLOCK1. (IN), OSC1.1, Z8.3 (C), Z8.11 (C), Z9.3 (C)
D0: BIOS1.11 (D0), BIOS2.11 (D0), BUF1.9 (Q0), CPU1.14 (D0), KBD1.1 (Out0), MK4116x1.1 (Din0), MK4116x1.18 (D0), VRAM2., pulldown1.1
D1: BIOS1.12 (D1), BIOS2.12 (D1), BUF1.10 (Q1), CPU1.15 (D1), KBD1.3 (Out1), MK4116x1.2 (Din1), MK4116x1.19 (D1), VRAM2., pulldown2.1
D2: BIOS1.13 (D2), BIOS2.13 (D2), BUF1.11 (Q2), CPU1.12 (D2), KBD1.5 (Out2), MK4116x1.3 (Din2), MK4116x1.20 (D2), VRAM2., pulldown3.1
D3: BIOS1.15 (D3), BIOS2.15 (D3), BUF1.12 (Q3), CPU1.8 (D3), KBD1.7 (Out3), MK4116x1.4 (Din3), MK4116x1.21 (D3), VRAM2., pulldown4.1
D4: BIOS1.16 (D4), BIOS2.16 (D4), BUF1.13 (Q4), CPU1.7 (D4), KBD1.9 (Out4), MK4116x1.5 (Din4), MK4116x1.22 (D4), VRAM2., pulldown5.1
D5: BIOS1.17 (D5), BIOS2.17 (D5), BUF1.14 (Q5), CPU1.9 (D5), KBD1.11 (Out5), MK4116x1.6 (Din5), MK4116x1.23 (D5), VRAM2., pulldown6.1
D6: BIOS1.18 (D6), BIOS2.18 (D6), BUF1.15 (Q6), CPU1.10 (D6), KBD1.14 (Out6), MK4116x1.7 (Din6), MK4116x1.24 (D6), VRAM2., pulldown7.1
D7: BIOS1.19 (D7), BIOS2.19 (D7), BUF1.16 (Q7), CPU1.13 (D7), KBD1.16 (Out7), MK4116x1.8 (Din7), MK4116x1.25 (D7), VRAM2., pulldown8.1
GND: CHAR_GEN2.17 (~CS), GFX_SHFT2.1 (Ds), GFX_SHFT2.2 (A), GFX_SHFT2.3 (B), GFX_SHFT2.6 (CE), MUX4x2.6 (A3), MUX4x2.10 (B3), RESET1.1 (IN1), TXT_SHFT2.1 (Ds), TXT_SHFT2.2 (A), TXT_SHFT2.3 (B), TXT_SHFT2.6 (CE), TXT_SHFT2.14 (H), VRAM2., Z31.2 (D)
HSync: Display2.2 (HSync), NOR1.1 (IN0), VCNT_CHAR2.5 (Q3), VCNT_CHAR_LINE1.1 (C), Z28.4
KV: DEC1.7 (Q3), NOT1. (IN), pullup4.1
KYBD: KBD1.19 (En), Z6.8
L1: CHAR_GEN2.11 (RS1), VCNT_CHAR_LINE1.2 (Q0)
L2: CHAR_GEN2.10 (RS2), VCNT_CHAR_LINE1.3 (Q1)
L4: AND3.1 (IN0), CHAR_GEN2.8 (RS3), MUX4x2.1 (N0), VCNT_CHAR_LINE1.4 (Q2)
L8: AND3.2 (IN1), MUX4x2.2 (N1), VCNT_CHAR1.14 (CP0), VCNT_CHAR_LINE1.5 (Q3), Z32.12 (D2)
MUX: MUX2x1.1 (N0), Z8.9 (Q), Z9.2 (D)
unnamed: 4AND1.1 (IN0), DEC1.8 (Q4), pullup5.1
unnamed: 4AND1.2 (IN1), DEC1.9 (Q5), pullup6.1
unnamed: 4AND1.4 (IN2), DEC1.10 (Q6), pullup7.1
unnamed: 4AND1.5 (IN3), DEC1.11 (Q7), pullup8.1
unnamed: AND1.3 (OUT), Display2.1 (Clock)
unnamed: AND2.1 (IN0), DEC1.4 (Q0), pullup1.1
unnamed: AND2.2 (IN1), DEC1.5 (Q1), pullup2.1
unnamed: AND3.3 (OUT), VCNT_CHAR_LINE1.1 (C)
unnamed: AND5.1 (IN0), RESET1.2 (IN2), pullup11.1
unnamed: AND5.2 (IN1), CPU1.18 (~HALT)
unnamed: AND5.3 (OUT), CPU1.17 (~NMI)
unnamed: CNT_CLOCK1.4 (Q2), CPU1.6 (~CLK)
unnamed: CNT_VID1.1 (CP1..3), CNT_VID1.12 (Q0), U1.1
unnamed: CNT_VID1.9 (Q2), U1.2
unnamed: CPU1.16 (~INT), pullup21.1
unnamed: CPU1.24 (~WAIT), pullup19.1
unnamed: CPU1.25 (~BUSRQ), pullup22.1
unnamed: CPU1.26 (~RESET), pullup20.1
unnamed: DEC1.12 (~CS), Z2.6
unnamed: Display2.4 (Vin), OR1.3 (OUT)
unnamed: GFX_SHFT2.9 (Clr), pullup29.1
unnamed: GFX_SHFT2.4 (C), GFX_SHFT2.5 (D), GFX_SHFT2.10 (E), MUX4x2.11 (QA)
unnamed: GFX_SHFT2.11 (F), GFX_SHFT2.12 (G), GFX_SHFT2.14 (H), MUX4x2.12 (QB)
unnamed: GFX_SHFT2.13 (Qh), OR1.1 (IN0)
unnamed: MK4116x1.26 (~CAS), OR3.3 (OUT)
unnamed: NAND1.2 (IN1), NOT1.1 (OUT)
unnamed: NAND1.3 (OUT), Z2.12, Z6.10
unnamed: OR1.2 (IN1), TXT_SHFT2.13 (Qh)
unnamed: TXT_SHFT2.9 (Clr), pullup28.1
unnamed: U6.1, Z32.7 (Q1), Z33.10
unnamed: U6.2, Z32.2 (Q0)
unnamed: U6.8, Z1.4, Z33.9
unnamed: VCNT_CHAR2.1 (C), Z28.6
unnamed: VCNT_ROW1.1 (C), Z28.12
unnamed: Z1.2, Z2.13
unnamed: Z7.3, Z8.1 (~R), Z8.2 (D), Z8.13 (~R), Z9.1 (~R)
unnamed: Z8.5 (Q), Z8.12 (D)
unnamed: Z32.3 (~Q0), Z33.12
unnamed: Z32.11 (~Q2), Z33.13
R1: MUX_VRAM1.20 (G1), VCNT_CHAR1.12 (Q0), VCNT_ROW1.1 (C)
R2: MUX_VRAM1.24 (H1), VCNT_ROW1.2 (Q0), Z28.13
R4: MUX_VRAM1.11 (I1), VCNT_ROW1.3 (Q1)
R8: MUX_VRAM1.15 (J1), VCNT_ROW1.4 (Q2), Z28.2
RAM: 4AND1.3 (OUT), OR3.2 (IN1)
RD: OR2.1 (IN0), Z18.6
ROMA: AND2.3 (OUT), BIOS1.20 (~CE)
ROMB: BIOS2.20 (~CE), DEC1.6 (Q2), pullup3.1
SHIFTGFX: GFX_SHFT2.15 (PE), U6.9
SHIFTTXT: TXT_SHFT2.15 (PE), Z33.8
SMA0: MK4116x1.11 (A0), MUX2x1.6 (QA)
SMA1: MK4116x1.13 (A1), MUX2x1.12 (QB)
SMA2: MK4116x1.12 (A2), MUX2x1.14 (QC)
SMA3: MK4116x1.16 (A3), MUX2x1.20 (QD)
SMA4: MK4116x1.15 (A4), MUX2x1.7 (QE)
SMA5: MK4116x1.14 (A5), MUX2x1.13 (QF)
SMA6: MK4116x1.17 (A6), MUX2x1.15 (QG)
V0: MUX_VRAM1.26 (QA), VRAM2.
V1: MUX_VRAM1.27 (QB), VRAM2.
V2: MUX_VRAM1.28 (QC), VRAM2.
V3: MUX_VRAM1.29 (QD), VRAM2.
V4: MUX_VRAM1.31 (QE), VRAM2.
V5: MUX_VRAM1.33 (QF), VRAM2.
V6: MUX_VRAM1.35 (QG), VRAM2.
V7: MUX_VRAM1.37 (QH), VRAM2.
V8: MUX_VRAM1.30 (QI), VRAM2.
V9: MUX_VRAM1.32 (QJ), VRAM2.
VCLR: VRAM_BUF2.1 (~Mr), Z31.6 (~Q), Z32.1 (~Mr)
VID: MUX_VRAM1.25 (N0), OR2.2 (IN1), OR4.1 (IN0), Z2.11, Z31.4 (~S)
VRAM_LATCH: U1.3, VRAM_BUF2.9 (Cp), Z1.3, Z31.3 (C), Z32.9 (Cp)
VRD: BUF1.17 (~CS), OR2.3 (OUT)
VSync: Display2.3 (VSync), NOR1.2 (IN1), VCNT_ROW1.5 (Q3), Z28.1
VWR: OR4.3 (OUT), VRAM2.
WR: MK4116x1.9 (~WE), OR4.2 (IN1), Z18.11

Notes on the sheet:
Z80
