kopavel/KiCadLogicalSchemeSimulator/schemaParts/dcTrigger/test/resources/dcTrigger.kicad_sch

## KiCad design schemaParts/dcTrigger/test/resources/dcTrigger.kicad_sch (2024-08-24)

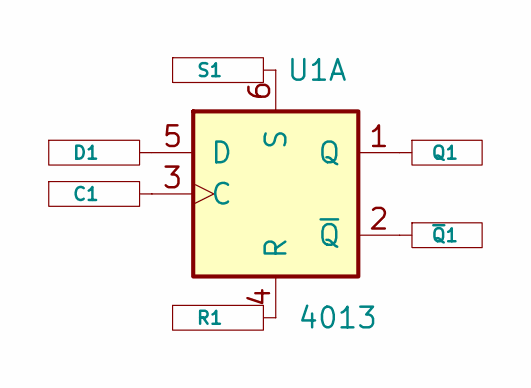
[picture p24: schematic dcTrigger.kicad_sch]

Parts:
C1: OutPin
D1: OutPin
Q1: InPin
R1: OutPin
S1: OutPin
U1: 4013
~{Q}1: InPin

Connections:
unnamed: C1.1, U1.3 (C)
unnamed: D1.1, U1.5 (D)
unnamed: Q1.1, U1.1 (Q)
unnamed: R1.1, U1.4 (R)
unnamed: S1.1, U1.6 (S)
unnamed: U1.2 (~Q), ~{Q}1.1
