kopavel/KiCadLogicalSchemeSimulator/schemaParts/decoder/test/resources/MultiOutDecoder.kicad_sch

## KiCad design schemaParts/decoder/test/resources/MultiOutDecoder.kicad_sch (2025-05-03)

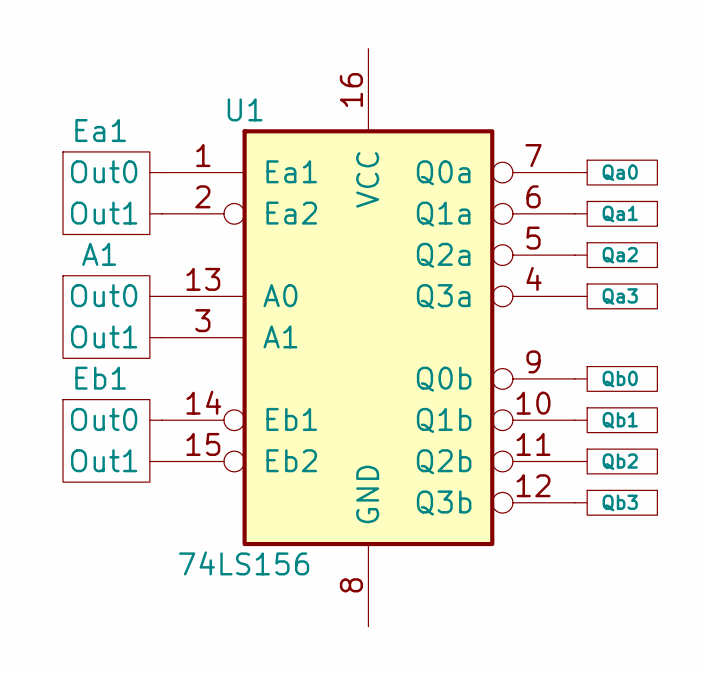
[picture p25: schematic MultiOutDecoder.kicad_sch]

Parts:
A1: OutBus2x
Ea1: OutBus2x
Eb1: OutBus2x
Qa0, Qa1, Qa2, Qa3: InPin
Qb0, Qb1, Qb2, Qb3: InPin
U1: 74LS156

Connections:
unnamed: A1.0 (Out0), U1.13 (A0)
unnamed: A1.1 (Out1), U1.3 (A1)
unnamed: Ea1.0 (Out0), U1.1 (Ea1)
unnamed: Ea1.1 (Out1), U1.2 (Ea2)
unnamed: Eb1.0 (Out0), U1.14 (Eb1)
unnamed: Eb1.1 (Out1), U1.15 (Eb2)
unnamed: Qa0.1, U1.7 (Q0a)
unnamed: Qa1.1, U1.6 (Q1a)
unnamed: Qa2.1, U1.5 (Q2a)
unnamed: Qa3.1, U1.4 (Q3a)
unnamed: Qb0.1, U1.9 (Q0b)
unnamed: Qb1.1, U1.10 (Q1b)
unnamed: Qb2.1, U1.11 (Q2b)
unnamed: Qb3.1, U1.12 (Q3b)
