kopavel/KiCadLogicalSchemeSimulator/schemaParts/diode/test/resources/diode.kicad_sch

## KiCad design schemaParts/diode/test/resources/diode.kicad_sch (2024-08-30)

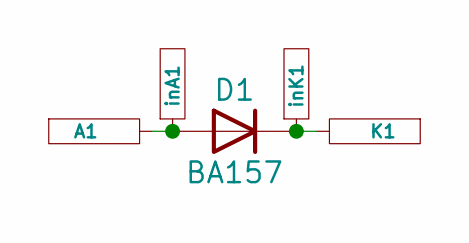
[picture p26: schematic diode.kicad_sch]

Parts:
A1: OutPin
D1: BA157; D_DO-41_SOD81_P10.16mm_Horizontal
K1: OutPin
inA1: InPin
inK1: InPin

Connections:
unnamed: A1.1, D1.2 (A), inA1.1
unnamed: D1.1 (K), K1.1, inK1.1
