kopavel/KiCadLogicalSchemeSimulator/schemaParts/jkTrigger/test/resources/jkTrigger.kicad_sch

## KiCad design schemaParts/jkTrigger/test/resources/jkTrigger.kicad_sch (2024-08-26)

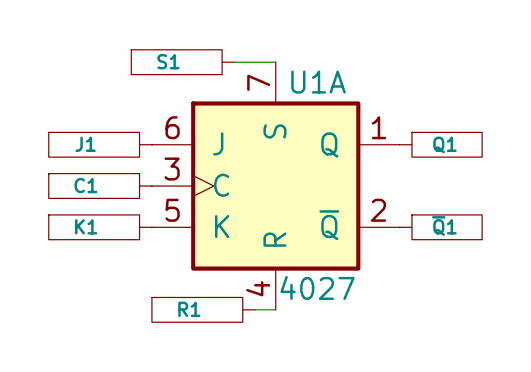
[picture p27: schematic jkTrigger.kicad_sch]

Parts:
C1: OutPin
J1: OutPin
K1: OutPin
Q1: InPin
R1: OutPin
S1: OutPin
U1: 4027
~{Q}1: InPin

Connections:
unnamed: C1.1, U1.3 (C)
unnamed: J1.1, U1.6 (J)
unnamed: K1.1, U1.5 (K)
unnamed: Q1.1, U1.1 (Q)
unnamed: R1.1, U1.4 (R)
unnamed: S1.1, U1.7 (S)
unnamed: U1.2 (~Q), ~{Q}1.1
