kopavel/KiCadLogicalSchemeSimulator/schemaParts/multiplexer/test/resources/maskedMultiplexer.kicad_sch

## KiCad design schemaParts/multiplexer/test/resources/maskedMultiplexer.kicad_sch (2024-09-03)

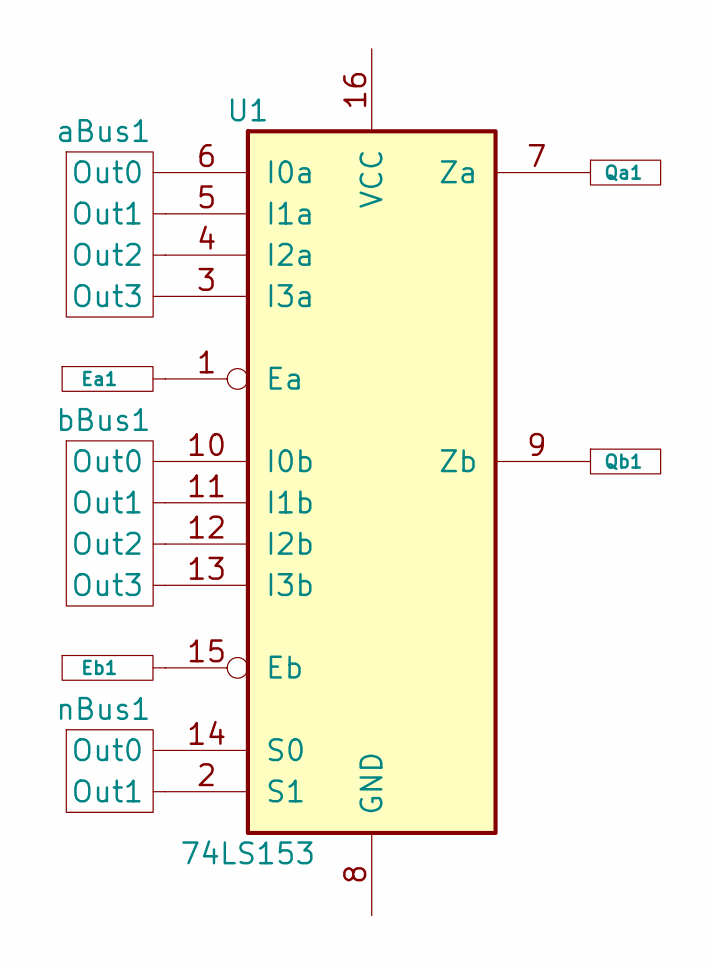
[picture p28: schematic maskedMultiplexer.kicad_sch]

Parts:
Ea1: OutPin
Eb1: OutPin
Qa1: InPin
Qb1: InPin
U1: 74LS153
aBus1: OutBus4x
bBus1: OutBus4x
nBus1: OutBus2x

Connections:
unnamed: Ea1.1, U1.1 (Ea)
unnamed: Eb1.1, U1.15 (Eb)
unnamed: Qa1.1, U1.7 (Za)
unnamed: Qb1.1, U1.9 (Zb)
unnamed: U1.2 (S1), nBus1.1 (Out1)
unnamed: U1.3 (I3a), aBus1.3 (Out3)
unnamed: U1.4 (I2a), aBus1.2 (Out2)
unnamed: U1.5 (I1a), aBus1.1 (Out1)
unnamed: U1.6 (I0a), aBus1.0 (Out0)
unnamed: U1.10 (I0b), bBus1.0 (Out0)
unnamed: U1.11 (I1b), bBus1.1 (Out1)
unnamed: U1.12 (I2b), bBus1.2 (Out2)
unnamed: U1.13 (I3b), bBus1.3 (Out3)
unnamed: U1.14 (S0), nBus1.0 (Out0)
