kopavel/KiCadLogicalSchemeSimulator/schemaParts/multiplexer/test/resources/multiplexer.kicad_sch

## KiCad design schemaParts/multiplexer/test/resources/multiplexer.kicad_sch (2024-09-03)

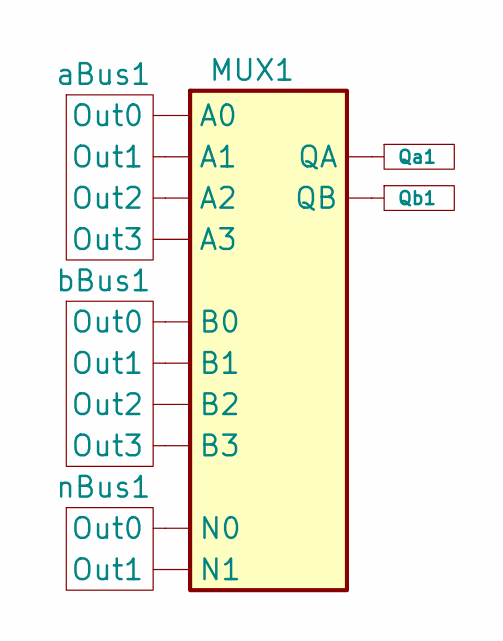
[picture p29: schematic multiplexer.kicad_sch]

Parts:
MUX1: MUX
Qa1: InPin
Qb1: InPin
aBus1: OutBus4x
bBus1: OutBus4x
nBus1: OutBus2x

Connections:
unnamed: MUX1.1 (N0), nBus1.0 (Out0)
unnamed: MUX1.2 (N1), nBus1.1 (Out1)
unnamed: MUX1.3 (A0), aBus1.0 (Out0)
unnamed: MUX1.4 (A1), aBus1.1 (Out1)
unnamed: MUX1.5 (A2), aBus1.2 (Out2)
unnamed: MUX1.6 (A3), aBus1.3 (Out3)
unnamed: MUX1.7 (B0), bBus1.0 (Out0)
unnamed: MUX1.8 (B1), bBus1.1 (Out1)
unnamed: MUX1.9 (B2), bBus1.2 (Out2)
unnamed: MUX1.10 (B3), bBus1.3 (Out3)
unnamed: MUX1.11 (QA), Qa1.1
unnamed: MUX1.12 (QB), Qb1.1
