kopavel/KiCadLogicalSchemeSimulator/schemaParts/or/test/resources/Or.kicad_sch

## KiCad design schemaParts/or/test/resources/Or.kicad_sch (2024-08-23)

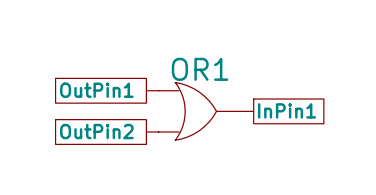
[picture p30: schematic Or.kicad_sch]

Parts:
InPin1: InPin
OR1: OR
OutPin1, OutPin2: OutPin

Connections:
unnamed: InPin1.1, OR1.3 (OUT)
unnamed: OR1.1 (IN0), OutPin1.1
unnamed: OR1.2 (IN1), OutPin2.1
