kopavel/KiCadLogicalSchemeSimulator/schemaParts/ram/test/resources/ram.kicad_sch

## KiCad design schemaParts/ram/test/resources/ram.kicad_sch (2024-08-26)

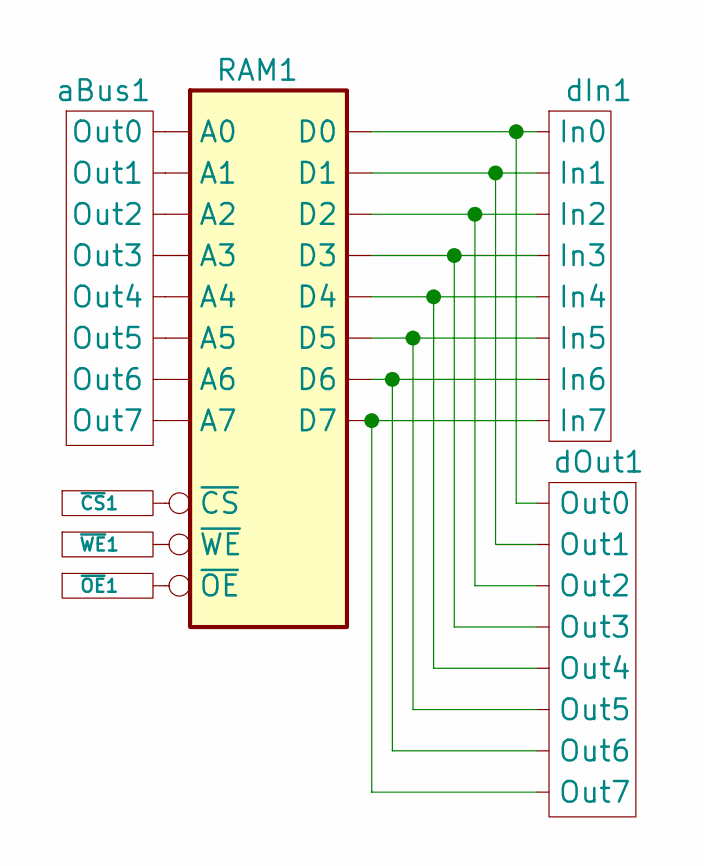
[picture p31: schematic ram.kicad_sch]

Parts:
RAM1: RAM
aBus1: OutBus
dIn1: InBus
dOut1: OutBus
~{CS}1: OutPin
~{OE}1: OutPin
~{WE}1: OutPin

Connections:
unnamed: RAM1.1 (A0), aBus1.0 (Out0)
unnamed: RAM1.2 (A1), aBus1.1 (Out1)
unnamed: RAM1.3 (A2), aBus1.2 (Out2)
unnamed: RAM1.4 (A3), aBus1.3 (Out3)
unnamed: RAM1.5 (A4), aBus1.4 (Out4)
unnamed: RAM1.6 (A5), aBus1.5 (Out5)
unnamed: RAM1.7 (A6), aBus1.6 (Out6)
unnamed: RAM1.8 (A7), aBus1.7 (Out7)
unnamed: RAM1.17 (D0), dIn1.0 (In0), dOut1.0 (Out0)
unnamed: RAM1.18 (D1), dIn1.1 (In1), dOut1.1 (Out1)
unnamed: RAM1.19 (D2), dIn1.2 (In2), dOut1.2 (Out2)
unnamed: RAM1.20 (D3), dIn1.3 (In3), dOut1.3 (Out3)
unnamed: RAM1.21 (D4), dIn1.4 (In4), dOut1.4 (Out4)
unnamed: RAM1.22 (D5), dIn1.5 (In5), dOut1.5 (Out5)
unnamed: RAM1.23 (D6), dIn1.6 (In6), dOut1.6 (Out6)
unnamed: RAM1.24 (D7), dIn1.7 (In7), dOut1.7 (Out7)
unnamed: RAM1.26 (~CS), ~{CS}1.1
unnamed: RAM1.27 (~OE), ~{OE}1.1
unnamed: RAM1.28 (~WE), ~{WE}1.1
