kopavel/KiCadLogicalSchemeSimulator/schemaParts/repeater/test/resources/repeater.kicad_sch

## KiCad design schemaParts/repeater/test/resources/repeater.kicad_sch (2024-08-26)

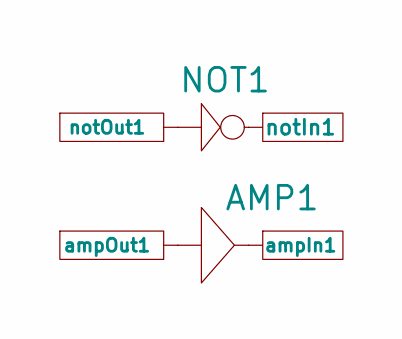
[picture p32: schematic repeater.kicad_sch]

Parts:
AMP1: AMP
NOT1: NOT
ampIn1: InPin
ampOut1: OutPin
notIn1: InPin
notOut1: OutPin

Connections:
unnamed: AMP1.1 (OUT), ampIn1.1
unnamed: AMP1. (IN), ampOut1.1
unnamed: NOT1.1 (OUT), notIn1.1
unnamed: NOT1. (IN), notOut1.1
