kopavel/KiCadLogicalSchemeSimulator/schemaParts/ringCounter/test/resources/jnCounter.kicad_sch

## KiCad design schemaParts/ringCounter/test/resources/jnCounter.kicad_sch (2024-08-26)

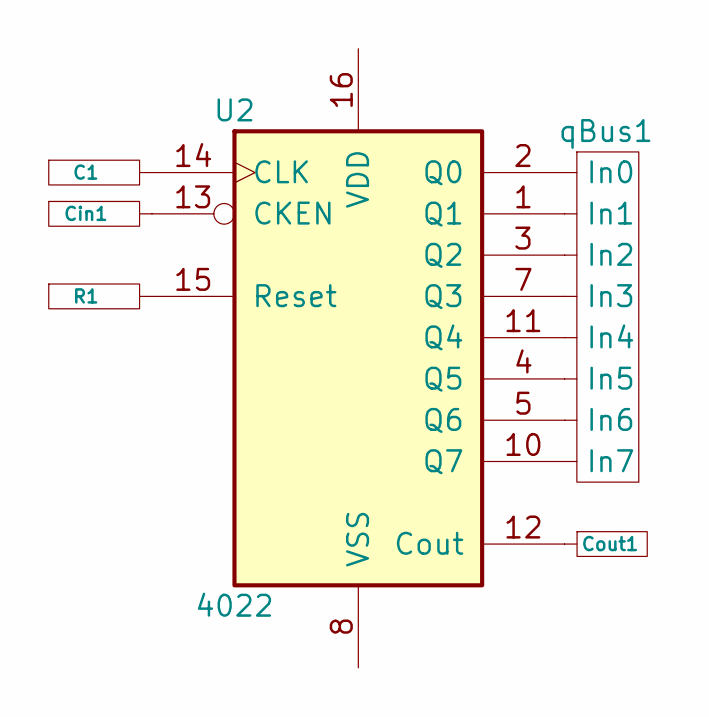
[picture p33: schematic jnCounter.kicad_sch]

Parts:
C1: OutPin
Cin1: OutPin
Cout1: InPin
R1: OutPin
U2: 4022
qBus1: InBus

Connections:
unnamed: C1.1, U2.14 (CLK)
unnamed: Cin1.1, U2.13 (CKEN)
unnamed: Cout1.1, U2.12 (Cout)
unnamed: R1.1, U2.15 (Reset)
unnamed: U2.1 (Q1), qBus1.1 (In1)
unnamed: U2.2 (Q0), qBus1.0 (In0)
unnamed: U2.3 (Q2), qBus1.2 (In2)
unnamed: U2.4 (Q5), qBus1.5 (In5)
unnamed: U2.5 (Q6), qBus1.6 (In6)
unnamed: U2.7 (Q3), qBus1.3 (In3)
unnamed: U2.10 (Q7), qBus1.7 (In7)
unnamed: U2.11 (Q4), qBus1.4 (In4)
