kopavel/KiCadLogicalSchemeSimulator/schemaParts/rom/test/resources/rom.kicad_sch

## KiCad design schemaParts/rom/test/resources/rom.kicad_sch (2024-08-26)

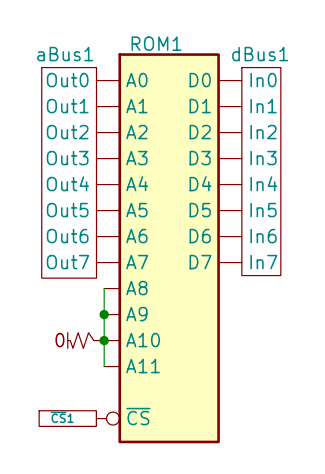
[picture p34: schematic rom.kicad_sch]

Parts:
ROM1: ROM
aBus1: OutBus
dBus1: InBus
pulldown1: pull_down
~{CS}1: OutPin

Connections:
unnamed: ROM1.1 (A0), aBus1.0 (Out0)
unnamed: ROM1.2 (A1), aBus1.1 (Out1)
unnamed: ROM1.5 (A2), aBus1.2 (Out2)
unnamed: ROM1.6 (A3), aBus1.3 (Out3)
unnamed: ROM1.7 (A4), aBus1.4 (Out4)
unnamed: ROM1.8 (A5), aBus1.5 (Out5)
unnamed: ROM1.9 (A6), aBus1.6 (Out6)
unnamed: ROM1.10 (A7), aBus1.7 (Out7)
unnamed: ROM1.3 (A10), ROM1.4 (A11), ROM1.11 (A8), ROM1.12 (A9), pulldown1.1
unnamed: ROM1.13 (D0), dBus1.0 (In0)
unnamed: ROM1.14 (D1), dBus1.1 (In1)
unnamed: ROM1.15 (D2), dBus1.2 (In2)
unnamed: ROM1.16 (D3), dBus1.3 (In3)
unnamed: ROM1.17 (D4), dBus1.4 (In4)
unnamed: ROM1.18 (D5), dBus1.5 (In5)
unnamed: ROM1.19 (D6), dBus1.6 (In6)
unnamed: ROM1.20 (D7), dBus1.7 (In7)
unnamed: ROM1.21 (~CS), ~{CS}1.1
