kopavel/KiCadLogicalSchemeSimulator/schemaParts/sdram/test/resources/sdRam.kicad_sch

## KiCad design schemaParts/sdram/test/resources/sdRam.kicad_sch (2024-08-26)

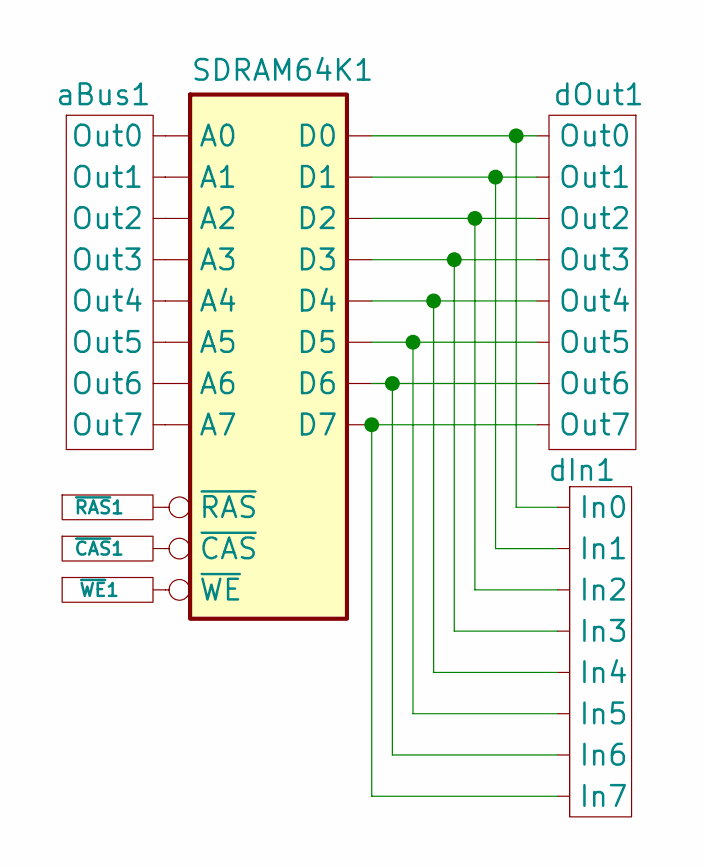
[picture p35: schematic sdRam.kicad_sch]

Parts:
SDRAM64K1: SDRAM64K
aBus1: OutBus
dIn1: InBus
dOut1: OutBus
~{CAS}1: OutPin
~{RAS}1: OutPin
~{WE}1: OutPin

Connections:
unnamed: SDRAM64K1.1 (A0), aBus1.0 (Out0)
unnamed: SDRAM64K1.2 (A1), aBus1.1 (Out1)
unnamed: SDRAM64K1.3 (A2), aBus1.2 (Out2)
unnamed: SDRAM64K1.4 (A3), aBus1.3 (Out3)
unnamed: SDRAM64K1.5 (A4), aBus1.4 (Out4)
unnamed: SDRAM64K1.6 (A5), aBus1.5 (Out5)
unnamed: SDRAM64K1.7 (A6), aBus1.6 (Out6)
unnamed: SDRAM64K1.8 (A7), aBus1.7 (Out7)
unnamed: SDRAM64K1.17 (D0), dIn1.0 (In0), dOut1.0 (Out0)
unnamed: SDRAM64K1.18 (D1), dIn1.1 (In1), dOut1.1 (Out1)
unnamed: SDRAM64K1.19 (D2), dIn1.2 (In2), dOut1.2 (Out2)
unnamed: SDRAM64K1.20 (D3), dIn1.3 (In3), dOut1.3 (Out3)
unnamed: SDRAM64K1.21 (D4), dIn1.4 (In4), dOut1.4 (Out4)
unnamed: SDRAM64K1.22 (D5), dIn1.5 (In5), dOut1.5 (Out5)
unnamed: SDRAM64K1.23 (D6), dIn1.6 (In6), dOut1.6 (Out6)
unnamed: SDRAM64K1.24 (D7), dIn1.7 (In7), dOut1.7 (Out7)
unnamed: SDRAM64K1.26 (~RAS), ~{RAS}1.1
unnamed: SDRAM64K1.27 (~CAS), ~{CAS}1.1
unnamed: SDRAM64K1.28 (~WE), ~{WE}1.1
