kopavel/KiCadLogicalSchemeSimulator/schemaParts/shifter/test/resources/shifter.kicad_sch

## KiCad design schemaParts/shifter/test/resources/shifter.kicad_sch (2024-08-27)

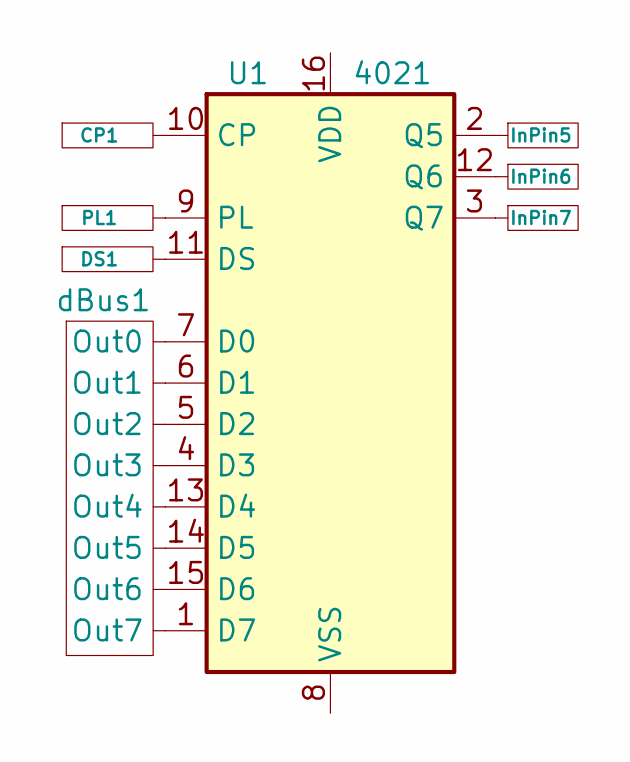
[picture p36: schematic shifter.kicad_sch]

Parts:
CP1: OutPin
DS1: OutPin
InPin5, InPin6, InPin7: InPin
PL1: OutPin
U1: 4021
dBus1: OutBus

Connections:
unnamed: CP1.1, U1.10 (CP)
unnamed: DS1.1, U1.11 (DS)
unnamed: InPin5.1, U1.2 (Q5)
unnamed: InPin6.1, U1.12 (Q6)
unnamed: InPin7.1, U1.3 (Q7)
unnamed: PL1.1, U1.9 (PL)
unnamed: U1.1 (D7), dBus1.7 (Out7)
unnamed: U1.4 (D3), dBus1.3 (Out3)
unnamed: U1.5 (D2), dBus1.2 (Out2)
unnamed: U1.6 (D1), dBus1.1 (Out1)
unnamed: U1.7 (D0), dBus1.0 (Out0)
unnamed: U1.13 (D4), dBus1.4 (Out4)
unnamed: U1.14 (D5), dBus1.5 (Out5)
unnamed: U1.15 (D6), dBus1.6 (Out6)
