kopavel/KiCadLogicalSchemeSimulator/schemaParts/switch/test/resources/switch.kicad_sch

## KiCad design schemaParts/switch/test/resources/switch.kicad_sch (2024-08-28)

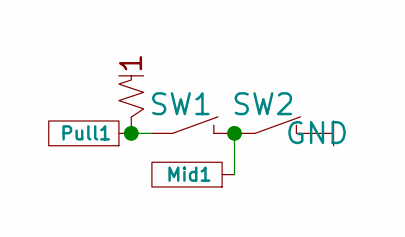
[picture p37: schematic switch.kicad_sch]

Parts:
Mid1: InPin
Pull1: InPin
SW1, SW2: SWITCH; SW_CW_GPTS203211B
pullup1: pull_up

Connections:
GND: SW2.2 (IN2)
unnamed: Mid1.1, SW1.2 (IN2), SW2.1 (IN1)
unnamed: Pull1.1, SW1.1 (IN1), pullup1.1
