kopavel/KiCadLogicalSchemeSimulator/simulator/src/test/resources/netBench.kicad_sch

## KiCad design simulator/src/test/resources/netBench.kicad_sch (2025-05-06)

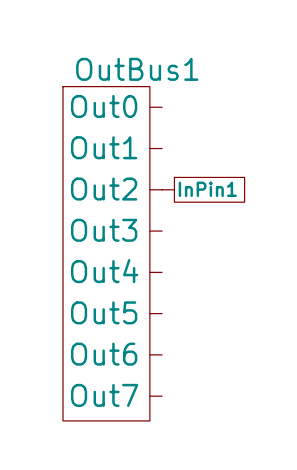
[picture p38: schematic netBench.kicad_sch]

Parts:
InPin1: InPin
OutBus1: OutBus

Connections:
unnamed: InPin1.1, OutBus1.2 (Out2)
