kopavel/KiCadLogicalSchemeSimulator/simulator/src/java/pko/KiCadLogicalSchemeSimulator/net/Net.java

/*
 *
 *  * Copyright (C) 2024 Pavel Korzh
 *  * SPDX-License-Identifier: GPL-3.0-only
 *
 */
package pko.KiCadLogicalSchemeSimulator.net;
import pko.KiCadLogicalSchemeSimulator.Simulator;
import pko.KiCadLogicalSchemeSimulator.api.IModelItem;
import pko.KiCadLogicalSchemeSimulator.api.ModelItem;
import pko.KiCadLogicalSchemeSimulator.api.NetFilter;
import pko.KiCadLogicalSchemeSimulator.api.ShortcutException;
import pko.KiCadLogicalSchemeSimulator.api.bus.Bus;
import pko.KiCadLogicalSchemeSimulator.api.bus.InBus;
import pko.KiCadLogicalSchemeSimulator.api.bus.OutBus;
import pko.KiCadLogicalSchemeSimulator.api.params.ParameterResolver;
import pko.KiCadLogicalSchemeSimulator.api.params.types.PinConfig;
import pko.KiCadLogicalSchemeSimulator.api.params.types.SchemaPartConfig;
import pko.KiCadLogicalSchemeSimulator.api.schemaPart.SchemaPart;
import pko.KiCadLogicalSchemeSimulator.api.wire.InPin;
import pko.KiCadLogicalSchemeSimulator.api.wire.OutPin;
import pko.KiCadLogicalSchemeSimulator.api.wire.PassivePin;
import pko.KiCadLogicalSchemeSimulator.api.wire.Pin;
import pko.KiCadLogicalSchemeSimulator.net.bus.BusInInterconnect;
import pko.KiCadLogicalSchemeSimulator.net.merger.MergerInput;
import pko.KiCadLogicalSchemeSimulator.net.merger.bus.BusMerger;
import pko.KiCadLogicalSchemeSimulator.net.merger.wire.WireMerger;
import pko.KiCadLogicalSchemeSimulator.net.wire.NCWire;
import pko.KiCadLogicalSchemeSimulator.net.wire.PassiveIn;
import pko.KiCadLogicalSchemeSimulator.parsers.pojo.net.Export;
import pko.KiCadLogicalSchemeSimulator.tools.Log;
import pko.KiCadLogicalSchemeSimulator.tools.Utils;

import java.util.*;
import java.util.stream.Collectors;

import static pko.KiCadLogicalSchemeSimulator.api.params.ParameterResolver.PowerState.gnd;
import static pko.KiCadLogicalSchemeSimulator.api.params.ParameterResolver.PowerState.pwr;

public class Net {
    public final Map<String, SchemaPart> schemaParts = new TreeMap<>(new Utils.AlphanumericComparator());
    public final String optimisedDir;
    public final ParameterResolver parameterResolver;
    private final Map<Pin, DestinationWireDescriptor> destinationWireDescriptors = new HashMap<>();
    private final Map<Bus, DestinationBusDescriptor> destinationBusDescriptors = new HashMap<>();
    private final Map<String, BusMerger> busMergers = new TreeMap<>();
    private final Map<String, WireMerger> wireMergers = new TreeMap<>();
    private final Map<IModelItem<?>, IModelItem<?>> replacement = new HashMap<>();
    public volatile boolean stabilizing = true;
    private List<MergerInput<?>> forRetry = new ArrayList<>();
    private boolean hasRetry = false;

    public Net(Export export, String optimisedDir, ParameterResolver parameterResolver) {
        this.optimisedDir = optimisedDir;
        this.parameterResolver = parameterResolver;
        Log.info(Net.class, "Start Net building");
        boolean doFilter = true;
        while (doFilter) {
            doFilter = false;
            for (NetFilter netFilter : ServiceLoader.load(NetFilter.class)) {
                boolean filterResult = netFilter.doFilter(export, parameterResolver);
                doFilter = doFilter || filterResult;
                if (filterResult) {
                    Log.info(Net.class, "Filter " + netFilter.getClass().getSimpleName() + " modify NET");
                }
            }
        }
        export.getNets().getNet().forEach(this::groupSourcesByDestinations);
        buildNet();
        Log.info(Net.class, "Stabilizing net");
        stabilise();
        Log.info(Net.class, "Net build complete");
    }

    public Pin processWire(Pin destination, Set<? extends OutPin> pins, List<? extends PassivePin> passivePins, Map<OutBus, Integer> buses) {
        Pin retVal = null;
        if (buses.size() + pins.size() + passivePins.size() > 1) {
            //connect a destination to multiple sources throe Merger
            String busesHash = buses.entrySet()
                    .stream().sorted(Comparator.comparing(entry -> entry.getKey().getName()))
                    .map(entry -> entry.getKey().getName() + ":mask" + entry.getKey().mask + "@" + entry.getValue())
                    .collect(Collectors.joining(";"));
            String mergerHash = Utils.getHash(pins, passivePins) + "|buses[" + busesHash + "]";
            if (wireMergers.containsKey(mergerHash)) {
                //Use old merger.
                OutPin oldMerger = wireMergers.get(mergerHash);
                oldMerger.addDestination(destination);
                retVal = oldMerger;
            } else {
                //collect merger as wire
                WireMerger newMerger = new WireMerger(destination, pins, passivePins, buses);
                retVal = newMerger;
                wireMergers.put(mergerHash, newMerger);
                if (!passivePins.isEmpty()) {
                    //Bus merger use passive but not regular pins throe wire merger. Index by passive pins either.
                    wireMergers.put(Utils.getHash(passivePins), newMerger);
                }
            }
        } else {
            //No merger needed.
            if (!pins.isEmpty() || !passivePins.isEmpty()) {
                //Pin-to-pin connection. Has only one regular or passive pin.
                for (OutPin pin : pins) {
                    pin.addDestination(destination);
                    retVal = pin;
                }
                for (OutPin pin : passivePins) {
                    pin.addDestination(destination);
                    retVal = pin;
                }
            } else {
                //bus-to-pin connection
                for (Map.Entry<OutBus, Integer> bus : buses.entrySet()) {
                    bus.getKey().addDestination(destination, bus.getValue());
                }
            }
        }
        return retVal;
    }

    public void retry() {
        assert Log.debug(getClass(), "tick");
        if (hasRetry) {
            int tryCount = 10;
            for (int i = 0; i < tryCount && hasRetry; i++) {
                Iterable<MergerInput<?>> items = forRetry;
                forRetry = new ArrayList<>();
                hasRetry = false;
                items.forEach(item -> {
                    assert Log.debug(Net.class, "Retry sending postponed pin {}", item);
                    item.retry();
                });
            }
            if (hasRetry) {
                MergerInput<?> item = forRetry.getFirst();
                throw new ShortcutException(item, item.getState(), item.getSources());
            }
        }
    }

    public void forRetry(MergerInput<?> item) {
        forRetry.add(item);
        hasRetry = true;
    }

    private void processInput(SchemaPart schemaPart,
            String pinName,
            SchemaPartConfig schemaPartConfig,
            Collection<Pin> destinationPins,
            Map<InBus, SortedSet<Byte>> destinationBusesOffsets) {
        IModelItem<?> destination = schemaPart.getInItem(pinName);
        if (replacement.containsKey(destination)) {
            destination = replacement.get(destination);
        }
        switch (destination) {
            case InPin pin -> destinationPins.add(pin);
            case InBus bus -> destinationBusesOffsets.computeIfAbsent(bus, _ -> new TreeSet<>()).add(bus.getAliasOffset(pinName));
            default -> throw new IllegalStateException("Unexpected input type: " + destination.getClass().getName());
        }
        if (schemaPartConfig.priority != null && schemaPartConfig.priority.containsKey(destination.getId())) {
            ((ModelItem<?>) destination).priority += schemaPartConfig.priority.get(destination.getId()) ? 1 : -1;
        }
    }

    private void processOutput(SchemaPart schemaPart, String pinName, String id, ParameterResolver.PowerState powerState, Map<IModelItem<?>, Byte> sourcesOffset) {
        if (powerState.strong) {
            throw new AssertionError("OUT pin " + id + "_" + pinName + " on power rail");
        }
        IModelItem<?> source = schemaPart.getOutItem(pinName);
        if (source == null) {
            throw new AssertionError("No pin named " + pinName + " in schema part " + schemaPart.id);
        }
        Byte aliasOffset = source.getAliasOffset(pinName);
        if (aliasOffset == null) {
            throw new AssertionError("No alias for pin " + pinName);
        }
        if (sourcesOffset.containsKey(source)) {
            throw new AssertionError("Shortcut on outputs. Part " + source.getName() + " Pin " + sourcesOffset.get(source) + " and " + aliasOffset);
        }
        sourcesOffset.put(source, aliasOffset);
    }

    private void groupSourcesByDestinations(pko.KiCadLogicalSchemeSimulator.parsers.pojo.net.Net net) {
        if (net.getName().startsWith("unconnected-")) {
            return;
        }
        Map<IModelItem<?>, Byte> sourcesOffset = new HashMap<>();
        Collection<Pin> destinationPins = new ArrayList<>();
        Map<InBus, SortedSet<Byte>> destinationBusesOffsets = new HashMap<>();
        List<PassivePin> passivePins = new ArrayList<>();
        ParameterResolver.PowerState powerState = parameterResolver.getPowerState(net);
        net.getNode().forEach(node -> {
            SchemaPartConfig schemaPartConfig = parameterResolver.getSchemaPartConfig(node);
            if (schemaPartConfig == null || schemaPartConfig.ignore) {
                return;
            }
            PinConfig pinConfig = parameterResolver.getPinConfig(node);
            String id = pinConfig == null ? node.ref : parameterResolver.getId(node);
            SchemaPart schemaPart = schemaParts.computeIfAbsent(id, _ -> createSchemaPart(schemaPartConfig.clazz, id, schemaPartConfig.getParamString()));
            String pinName = pinConfig == null ? node.getPinfunction() : pinConfig.pinName;
            SchemaPart.PinType pinType = schemaPart.getPinType(pinName);
            if (pinType == null) {
                throw new RuntimeException("Can't determinate pin type for " + id + ":" + pinName);
            }
            switch (pinType) {
                case input -> processInput(schemaPart, pinName, schemaPartConfig, destinationPins, destinationBusesOffsets);
                case output -> processOutput(schemaPart, pinName, id, powerState, sourcesOffset);
                case bidirectional -> {
                    processInput(schemaPart, pinName, schemaPartConfig, destinationPins, destinationBusesOffsets);
                    processOutput(schemaPart, pinName, id, powerState, sourcesOffset);
                }
                case passive -> {
                    if (powerState.strong) {
                        destinationPins.add(new PassiveIn((PassivePin) schemaPart.getOutPin(pinName)));
                    } else {
                        passivePins.add((PassivePin) schemaPart.getOutPin(pinName));
                    }
                }
            }
        });
        if ((destinationPins.isEmpty())) {
            if (passivePins.size() == 1) {
                //Passive pin works as input-only
                destinationPins.add(new PassiveIn(passivePins.getFirst()));
                passivePins.clear();
            } else if (!passivePins.isEmpty()) {
                destinationPins.add(new NCWire(passivePins.getFirst()));
            } else if (destinationBusesOffsets.isEmpty()) {
                sourcesOffset.forEach((out, offset) -> Log.warn(Net.class, "Unconnected Out:" + out.getName() + offset));
            }
        }
        //
        //Process Pin destinations
        //
        destinationPins.forEach((destinationPin) -> {
            DestinationWireDescriptor descriptor = destinationWireDescriptors.computeIfAbsent(destinationPin, _ -> new DestinationWireDescriptor(passivePins));
            if (powerState == pwr) {
                SchemaPart pwr = createSchemaPart("Power", "pwr_" + destinationPin.getName(), "hi;strong");
                schemaParts.put(pwr.id, pwr);
                descriptor.add(pwr.getOutItem("OUT"), (byte) 0);
            } else if (powerState == gnd) {
                SchemaPart gnd = createSchemaPart("Power", "gnd_" + destinationPin.getName(), "strong");
                schemaParts.put(gnd.id, gnd);
                descriptor.add(gnd.getOutItem("OUT"), (byte) 0);
            } else {
                sourcesOffset.forEach(descriptor::add);
            }
        });
        //
        //Process Bus destinations
        //
        destinationBusesOffsets.forEach((destinationBus, destinationOffsets) -> {
            DestinationBusDescriptor descriptor =
                    destinationBusDescriptors.computeIfAbsent((Bus) replacement.getOrDefault(destinationBus, destinationBus), _ -> new DestinationBusDescriptor());
            if (powerState == pwr) {
                for (Byte destinationOffset : destinationOffsets) {
                    SchemaPart pwr = createSchemaPart("Power", "pwr_" + destinationBus.getName() + ":" + destinationOffset, "hi;strong");
                    schemaParts.put(pwr.id, pwr);
                    descriptor.add(pwr.getOutItem("OUT"), (byte) 0, destinationOffset);
                }
            } else if (powerState == gnd) {
                for (Byte destinationOffset : destinationOffsets) {
                    SchemaPart gnd = createSchemaPart("Power", "gnd_" + destinationBus.getName() + ":" + destinationOffset, "strong");
                    schemaParts.put(gnd.id, gnd);
                    descriptor.add(gnd.getOutItem("OUT"), (byte) 0, destinationOffset);
                }
            } else {
                if (destinationOffsets.size() > 1) {
                    // interconnected Bus pins
                    destinationBusDescriptors.remove(destinationBus);
                    int interconnectMask = 0;
                    for (Byte offset : destinationOffsets) {
                        interconnectMask |= (1 << offset);
                    }
                    Byte offset = destinationOffsets.getFirst();
                    destinationOffsets.clear();
                    destinationOffsets.add(offset);
                    BusInInterconnect interconnect = new BusInInterconnect(destinationBus, interconnectMask, offset);
                    destinationBusDescriptors.put(interconnect, descriptor);
                    replacement.put(destinationBus, interconnect);
                }
                sourcesOffset.forEach((source, sourceOffset) -> descriptor.add(source, sourceOffset, destinationOffsets.getFirst()));
            }
            passivePins.forEach(passivePin -> descriptor.add(passivePin, (byte) 0, destinationOffsets.getFirst()));
        });
    }

    private void buildNet() {
        //wire destinations
        destinationWireDescriptors.forEach((destination, descriptor) -> processWire(destination, descriptor.pins, descriptor.passivePins, descriptor.buses));
        //Bus destinations
        destinationBusDescriptors.forEach((destination, descriptor) -> {
            descriptor.cleanBuses();
            if (descriptor.useBusMerger()) {
                //Connect a destination to multiple sources throe Merger
                String busMergerHash = descriptor.getHash();
                if (busMergers.containsKey(busMergerHash)) {
                    //just connect to already created bus merger
                    busMergers.get(busMergerHash).addDestination(destination);
                } else {
                    //create new one bus merger
                    BusMerger busMerger = new BusMerger(destination);
                    //add all pins
                    descriptor.offsets.forEach((offset, lists) -> {
                        //search already processed wires
                        String passiveHash = Utils.getHash(lists.passivePins);
                        if (!passiveHash.isBlank() && wireMergers.containsKey(passiveHash)) {
                            //if found by passive pins – connect it and don't process further.
                            busMerger.addSource(wireMergers.get(passiveHash), offset);
                        } else {
                            //process unprocessed wire
                            busMerger.addSource(this, lists.pins, lists.passivePins, offset);
                        }
                    });
                    //add all buses
                    descriptor.buses.forEach((source, offsets) -> offsets.forEach((offset, mask) -> busMerger.addSource(source, mask, offset)));
                    busMergers.put(busMergerHash, busMerger);
                }
            } else {
                //use direct connect to destination
                if (descriptor.buses.isEmpty()) {
                    throw new RuntimeException("Impossible single wire-to-bus connection for destination " + destination.getName());
                } else {
                    //bus-to-bus connection
                    descriptor.buses.forEach((source, offsetMap) -> offsetMap.forEach((offset, mask) -> source.addDestination(destination, mask, offset)));
                }
            }
        });
        schemaParts.values().forEach(SchemaPart::optimiseOuts);
        for (OutPin wireMerger : wireMergers.values()) {
            wireMerger.getOptimised(null);
        }
        for (OutBus busMerger : busMergers.values()) {
            busMerger.getOptimised(null);
        }
    }

    private SchemaPart createSchemaPart(String className, String id, String params) {
        if (!Simulator.schemaPartSpiMap.containsKey(className)) {
            throw new RuntimeException("Unknown SchemaPart class " + className + " for SchemaPart id " + id);
        }
        SchemaPart schemaPart = Simulator.schemaPartSpiMap.get(className).getSchemaPart(id, params);
        if (schemaPart == null) {
            throw new RuntimeException("SchemaPart " + id + " class parameter doesn't reflect AbstractSchemaPart Java class");
        }
        schemaPart.net = this;
        return schemaPart;
    }

    private void stabilise() {
        if (schemaParts.values()
                .stream()
                .noneMatch(p -> "Oscillator".equals(p.getClass().getSimpleName()))) {
            //ToDo queue are not thread safe some lock mechanism?
            Thread.ofPlatform().daemon().start(() -> {
                while (true) {
                    retry();
                    try {
                        Thread.sleep(50);
                    } catch (InterruptedException e) {
                        Thread.currentThread().interrupt();
                        return;
                    }
                }
            });
        }
        schemaParts.values()
                .stream()
                .flatMap(p -> p.outPins.values()
                        .stream())
                .filter(modelItem -> !modelItem.isHiImpedance())
                .distinct()
                .forEach(item -> {
                    assert Log.debug(Net.class, "Resend pin {}", item);
                    item.resend();
                });
        wireMergers.values()
                .stream()
                .filter(outPin -> !outPin.isHiImpedance()).distinct().forEach(item -> {
                       assert Log.debug(Net.class, "Resend pin {}", item);
                       item.resend();
                   });
        busMergers.values()
                .stream()
                .filter(merger -> !merger.isHiImpedance()).distinct().forEach(item -> {
                      assert Log.debug(Net.class, "Resend pin {}", item);
                      item.resend();
                  });
        int resendTry = 10;
        for (int i = 0; i < resendTry; i++) {
            schemaParts.values().forEach(SchemaPart::reset);
            retry();
        }
        stabilizing = false;
        if (!forRetry.isEmpty()) {
            List<MergerInput<?>> items = forRetry;
            forRetry = new ArrayList<>();
            hasRetry = false;
            items.forEach(item -> {
                try {
                    item.retry();
                } catch (Throwable e) {
                    Log.error(Net.class, "Error at resend {}", item, e);
                }
            });
            Log.error(Net.class, "!!! Can't stabilize Net !!!");
        }
    }

    private static class BusPinsOffset {
        public final Set<OutPin> pins = new HashSet<>();
        public final List<PassivePin> passivePins = new ArrayList<>();
    }

    public static class DestinationWireDescriptor {
        //Bus, offset
        public final Map<OutBus, Integer> buses = new HashMap<>();
        //Pin, offset
        public final Set<OutPin> pins = new HashSet<>();
        public final List<PassivePin> passivePins;

        public DestinationWireDescriptor(List<PassivePin> passivePins) {
            this.passivePins = passivePins;
        }

        public void add(IModelItem<?> item, byte offset) {
            switch (item) {
                case OutPin pin -> pins.add(pin);
                case OutBus bus -> buses.put(bus, 1 << offset);
                default -> throw new IllegalStateException("Unsupported item: " + item.getClass().getName());
            }
        }
    }

    private static class DestinationBusDescriptor {
        //Bus, offset, mask
        public final Map<OutBus, Map<Byte, Integer>> buses = new HashMap<>();
        //Pin, offset
        public final Map<Byte, BusPinsOffset> offsets = new HashMap<>();

        public boolean useBusMerger() {
            return buses.values()
                    .stream().mapToLong(Map::size).sum() + offsets.size() > 1;
        }

        public void add(IModelItem<?> item, byte sourceOffset, byte destinationOffset) {
            switch (item) {
                case PassivePin passivePin -> offsets.computeIfAbsent(destinationOffset, _ -> new BusPinsOffset()).passivePins.add(passivePin);
                case OutPin pin -> offsets.computeIfAbsent(destinationOffset, _ -> new BusPinsOffset()).pins.add(pin);
                case OutBus bus -> {
                    byte offset = (byte) (destinationOffset - sourceOffset);
                    int newMask = buses.computeIfAbsent(bus, _ -> new HashMap<>()).computeIfAbsent(offset, _ -> 0) | (1 << sourceOffset);
                    buses.get(bus).put(offset, newMask);
                }
                default -> throw new IllegalStateException("Unsupported item: " + item.getClass().getName());
            }
        }

        //If “offset” has any passive pin – signal need to be processed using wire merger.
        //Drop respective bus mask from bus sources bit, other way got shortcut.
        public void cleanBuses() {
            if (!buses.isEmpty()) {
                offsets.forEach((pinsOffset, lists) -> {
                    if (!lists.passivePins.isEmpty()/*stream().anyMatch(p -> p.source != null)*/) {
                        //clean up all buses mask
                        buses.values()
                                .stream()
                                .flatMap(map -> map.entrySet()
                                        .stream())
                                .filter(o -> o.getKey() <= pinsOffset)
                                .forEach(pair -> {
                                    int correctedMask = ~(1 << (pinsOffset - pair.getKey()));
                                    pair.setValue(pair.getValue() & correctedMask);
                                });
                        //remove empty offsets
                        buses.values().forEach(map -> map.entrySet().removeIf(entry -> entry.getValue() == 0));
                        buses.entrySet().removeIf(entry -> entry.getValue().isEmpty());
                    }
                });
            }
        }

        public String getHash() {
            StringBuilder sb = new StringBuilder();
            sb.append("offsets[");
            offsets.entrySet()
                    .stream().sorted(Comparator.comparingInt(Map.Entry::getKey)).forEach((entry) -> {
                       Byte offset = entry.getKey();
                       BusPinsOffset lists = entry.getValue();
                       sb.append(offset).append(":{pass:[");
                       lists.passivePins.stream().sorted(Comparator.comparing(ModelItem::getName)).forEach(p -> sb.append(p.getName()).append(';'));
                       sb.append("],pins:[");
                       lists.pins.stream().sorted(Comparator.comparing(ModelItem::getName)).forEach(p -> sb.append(p.getName()).append(';'));
                       sb.append("]};");
                   });
            sb.append("]|buses[");
            buses.entrySet()
                    .stream().sorted(Comparator.comparing(entry -> entry.getKey().getName())).forEach((entry) -> {
                     sb.append(entry.getKey().getName()).append("={");
                     entry.getValue()
                          .entrySet()
                             .stream()
                             .sorted(Comparator.comparingInt(Map.Entry::getKey))
                             .forEach((entry1) -> sb.append(entry1.getKey()).append(':').append(entry1.getValue()).append(';'));
                     sb.append("};");
                 });
            sb.append("]");
            return sb.toString();
        }
    }
}
