kopavel/KiCadLogicalSchemeSimulator/simulator/src/java/pko/KiCadLogicalSchemeSimulator/model/Model.java

/*
 * Copyright (c) 2024 Pavel Korzh
 *
 * All rights reserved.
 *
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
 * 3. Neither the name of the copyright holder nor the names of its contributors
 * may be used to endorse or promote products derived from this software
 * without specific prior written permission.
 *
 * THIS SOFTWARE IS PROVIDED BY THE COPYRIGHT HOLDERS AND CONTRIBUTORS "AS IS"
 * AND ANY EXPRESS OR IMPLIED WARRANTIES, INCLUDING, BUT NOT LIMITED TO, THE
 * IMPLIED WARRANTIES OF MERCHANTABILITY AND FITNESS FOR A PARTICULAR PURPOSE
 * ARE DISCLAIMED. IN NO EVENT SHALL THE COPYRIGHT HOLDER OR CONTRIBUTORS BE
 * LIABLE FOR ANY DIRECT, INDIRECT, INCIDENTAL, SPECIAL, EXEMPLARY, OR
 * CONSEQUENTIAL DAMAGES (INCLUDING, BUT NOT LIMITED TO, PROCUREMENT OF
 * SUBSTITUTE GOODS OR SERVICES; LOSS OF USE, DATA, OR PROFITS; OR BUSINESS
 * INTERRUPTION) HOWEVER CAUSED AND ON ANY THEORY OF LIABILITY, WHETHER IN
 * CONTRACT, STRICT LIABILITY, OR TORT (INCLUDING NEGLIGENCE OR OTHERWISE)
 * ARISING IN ANY WAY OUT OF THE USE OF THIS SOFTWARE, EVEN IF ADVISED OF THE
 * POSSIBILITY OF SUCH DAMAGE.
 */
package pko.KiCadLogicalSchemeSimulator.model;
import pko.KiCadLogicalSchemeSimulator.api.IModelItem;
import pko.KiCadLogicalSchemeSimulator.api.ModelItem;
import pko.KiCadLogicalSchemeSimulator.api.bus.Bus;
import pko.KiCadLogicalSchemeSimulator.api.bus.OutBus;
import pko.KiCadLogicalSchemeSimulator.api.bus.in.InBus;
import pko.KiCadLogicalSchemeSimulator.api.schemaPart.SchemaPart;
import pko.KiCadLogicalSchemeSimulator.api.schemaPart.SchemaPartSpi;
import pko.KiCadLogicalSchemeSimulator.api.wire.OutPin;
import pko.KiCadLogicalSchemeSimulator.api.wire.PassiveOutPin;
import pko.KiCadLogicalSchemeSimulator.api.wire.PassivePin;
import pko.KiCadLogicalSchemeSimulator.api.wire.Pin;
import pko.KiCadLogicalSchemeSimulator.api.wire.in.InPin;
import pko.KiCadLogicalSchemeSimulator.model.bus.BusInInterconnect;
import pko.KiCadLogicalSchemeSimulator.model.merger.bus.BusMerger;
import pko.KiCadLogicalSchemeSimulator.model.merger.wire.WireMerger;
import pko.KiCadLogicalSchemeSimulator.model.wire.WireToBusAdapter;
import pko.KiCadLogicalSchemeSimulator.parsers.pojo.Comp;
import pko.KiCadLogicalSchemeSimulator.parsers.pojo.Export;
import pko.KiCadLogicalSchemeSimulator.parsers.pojo.Net;
import pko.KiCadLogicalSchemeSimulator.parsers.pojo.Property;
import pko.KiCadLogicalSchemeSimulator.parsers.pojo.symbolMap.SchemaPartMap;
import pko.KiCadLogicalSchemeSimulator.parsers.pojo.symbolMap.SymbolDesc;
import pko.KiCadLogicalSchemeSimulator.parsers.pojo.symbolMap.SymbolLibMap;
import pko.KiCadLogicalSchemeSimulator.tools.Log;
import pko.KiCadLogicalSchemeSimulator.tools.Utils;

import java.io.IOException;
import java.util.*;
import java.util.stream.Collectors;

import static java.lang.Boolean.FALSE;
import static java.lang.Boolean.TRUE;
import static pko.KiCadLogicalSchemeSimulator.model.SymbolDescriptions.PinMapDescriptor;
import static pko.KiCadLogicalSchemeSimulator.model.SymbolDescriptions.parse;
import static pko.KiCadLogicalSchemeSimulator.model.SymbolDescriptions.schemaPartPinMap;

public class Model {
    public static final Queue<IModelItem<?>> forResend = new LinkedList<>();
    public static boolean stabilizing;
    public final Map<String, SchemaPart> schemaParts = new TreeMap<>();
    public final Map<String, SchemaPartSpi> schemaPartSpiMap;
    private final Map<Pin, DestinationWireDescriptor> destinationWireDescriptors = new HashMap<>();
    private final Map<Bus, DestinationBusDescriptor> destinationBusDescriptors = new HashMap<>();
    private final Map<String, BusMerger> busMergers = new TreeMap<>();
    private final Map<String, OutPin> wires = new TreeMap<>();

    public Model(Export export, String mapPath) throws IOException {
        Log.info(Model.class, "Start Model building");
        schemaPartSpiMap = ServiceLoader.load(SchemaPartSpi.class)
                .stream()
                .map(ServiceLoader.Provider::get)
                .collect(Collectors.toMap(spi -> spi.getSchemaPartClass().getSimpleName(), spi -> spi));
        SchemaPartMap schemaPartMap = parse(mapPath);
        export.getComponents().getComp().forEach((Comp component) -> createSchemaPart(component, schemaPartMap));
        export.getNets().getNet().forEach(this::processNet);
        buildBuses();
        schemaParts.values().forEach(SchemaPart::initOuts);
        Log.info(Model.class, "Stabilizing model");
        stabilise();
        Log.info(Model.class, "Model build complete");
    }

    public Pin processWire(Pin destination, List<OutPin> pins, List<PassivePin> passivePins, Map<OutBus, Long> buses) {
        //passive pins chain used in direct connect and in mergers - always  process it.
        Pin retVal = null;
        boolean useOldWire = false;
        if (!passivePins.isEmpty()) {
            String destinationHash = Utils.getHash(passivePins);
            if (wires.containsKey(destinationHash)) {
                OutPin pin = wires.get(destinationHash);
                pin.addDestination(destination);
                retVal = pin;
                // if wire already processed before it is complete,so just add destination to it and don't process further
                useOldWire = true;
            } else {
                for (PassivePin passivePin : passivePins) {
                    passivePin.addDestination(destination);
                    destination = passivePin;
                }
                //collect passive pins chain as wire for further usage, if any
                wires.put(destinationHash, (OutPin) destination);
                retVal = destination;
            }
        }
        if (!useOldWire) {
            if (buses.size() + pins.size() > 1) {
                //connect destination to multiple sources throe Merger
                String mergerHash = Utils.getHash(pins, buses.keySet()) + "masks:" + buses.values()
                        .stream()
                        .map(String::valueOf)
                        .collect(Collectors.joining(":"));
                if (wires.containsKey(mergerHash)) {
                    //use old merger. in case if there is no passive pins - it's not handled earlier.
                    OutPin pin = wires.get(mergerHash);
                    pin.addDestination(destination);
                    retVal = pin;
                } else {
                    //collect merger as wire
                    WireMerger wireMerger = new WireMerger(destination, pins, buses);
                    retVal = wireMerger;
                    wires.put(mergerHash, wireMerger);
                }
            } else {
                //No merger needed. Passive pins, if any, are handled as pin chain in destination.
                if (!pins.isEmpty()) {
                    //pin-to-pin connection
                    for (OutPin pin : pins) {
                        pin.addDestination(destination);
                        retVal = pin;
                    }
                } else {
                    //bus-to-pin connection
                    for (Map.Entry<OutBus, Long> bus : buses.entrySet()) {
                        bus.getKey().addDestination(destination, bus.getValue());
                    }
                }
            }
        }
        return retVal;
    }

    private void processNet(Net net) {
        if (net.getName().startsWith("unconnected-")) {
            return;
        }
        Map<IModelItem<?>, Byte> sourcesOffset = new HashMap<>();
        List<Pin> destinationPins = new ArrayList<>();
        Map<InBus, SortedSet<Byte>> destinationBusesOffsets = new HashMap<>();
        List<PassivePin> passivePins = new ArrayList<>();
        Boolean powerState;
        if ("gnd".equalsIgnoreCase(net.getName())) {
            powerState = false;
        } else if ("pwr".equalsIgnoreCase(net.getName())) {
            powerState = true;
        } else {
            powerState = null;
        }
        net.getNode().forEach(node -> {
            Map<String, PinMapDescriptor> pinMap = schemaPartPinMap.get(node.getRef());
            String pinName;
            SchemaPart schemaPart;
            if (pinMap != null) {
                PinMapDescriptor pinMapDescriptor = pinMap.get(node.getPin());
                if (pinMapDescriptor == null) {
                    //ignore unmapped pins (power one?)
                    return;
                }
                pinName = pinMapDescriptor.pinName;
                schemaPart = pinMapDescriptor.schemaPart;
            } else {
                pinName = node.getPinfunction();
                schemaPart = this.schemaParts.get(node.getRef());
            }
            String pinType = node.getPintype();
            if (pinType.contains("+")) {
                pinType = pinType.substring(0, pinType.indexOf('+'));
            }
            switch (pinType) {
                case "input" -> {
                    IModelItem<?> destination = schemaPart.getInItem(pinName);
                    switch (destination) {
                        case InPin pin -> destinationPins.add(pin);
                        case InBus bus -> destinationBusesOffsets.computeIfAbsent(bus, p -> new TreeSet<>()).add(bus.getAliasOffset(pinName));
                        default -> throw new IllegalStateException("Unexpected input type: " + destination.getClass().getName());
                    }
                }
                case "tri_state", "output" -> {
                    if (powerState != null) {
                        throw new RuntimeException("OUt pin on power rail");
                    }
                    IModelItem<?> source = schemaPart.getOutItem(pinName);
                    sourcesOffset.put(source, source.getAliasOffset(pinName));
                }
                case "bidirectional" -> {
                    if (powerState != null) {
                        throw new RuntimeException("OUt pin on power rail");
                    }
                    IModelItem<?> destination = schemaPart.getInItem(pinName);
                    switch (destination) {
                        case InPin pin -> destinationPins.add(pin);
                        case InBus bus -> destinationBusesOffsets.computeIfAbsent(bus, p -> new TreeSet<>()).add(bus.getAliasOffset(pinName));
                        default -> throw new IllegalStateException("Unexpected input type: " + destination.getClass().getName());
                    }
                    IModelItem<?> source = schemaPart.getOutItem(pinName);
                    sourcesOffset.put(source, source.getAliasOffset(pinName));
                }
                case "passive" -> passivePins.add(schemaPart.passivePins.get(pinName));
                case "power_in" -> { //ignore
                }
                default -> throw new RuntimeException("Unsupported pin type " + pinType);
            }
        });
        if (powerState != null) {
            //if on power rail - connect all passive pin power rail it and don't add to any others nets
            passivePins.forEach(passivePin -> {
                if (TRUE == powerState) {
                    SchemaPart pwr = getSchemaPart("Power", "pwr_" + passivePin.getName(), "hi;strong");
                    schemaParts.put(pwr.id, pwr);
                    ((OutPin) pwr.getOutPin("OUT")).addDestination(passivePin);
                } else if (FALSE == powerState) {
                    SchemaPart gnd = getSchemaPart("Power", "gnd_" + passivePin.getName(), "strong");
                    schemaParts.put(gnd.id, gnd);
                    ((OutPin) gnd.getOutPin("OUT")).addDestination(passivePin);
                }
            });
            passivePins.clear();
        } else {
            //if there is no destination pins but is passive (no out only) pins - use one of it as destination, in other way passive pins don't get any changes
            if ((destinationPins.isEmpty())) {
                Optional<PassivePin> passivePin = passivePins.stream()
                        .filter(p -> !(p instanceof PassiveOutPin)).findAny();
                if (passivePin.isPresent()) {
                    destinationPins.add(passivePin.get());
                } else if (destinationBusesOffsets.isEmpty()) {
                    sourcesOffset.forEach((out, offset) -> Log.warn(Model.class, "Unconnected Out:" + out.getName() + offset));
                }
            }
        }
        //
        //Process Pin destinations
        //
        destinationPins.forEach((destinationPin) -> {
            DestinationWireDescriptor descriptor = destinationWireDescriptors.computeIfAbsent(destinationPin, i -> new DestinationWireDescriptor(passivePins));
            if (TRUE == powerState) {
                SchemaPart pwr = getSchemaPart("Power", "pwr_" + destinationPin.getName(), "hi;strong");
                schemaParts.put(pwr.id, pwr);
                descriptor.add(pwr.getOutItem("OUT"), (byte) 0);
            } else if (FALSE == powerState) {
                SchemaPart gnd = getSchemaPart("Power", "gnd_" + destinationPin.getName(), "strong");
                schemaParts.put(gnd.id, gnd);
                descriptor.add(gnd.getOutItem("OUT"), (byte) 0);
            } else {
                sourcesOffset.forEach(descriptor::add);
            }
        });
        //
        //Process Bus destinations
        //
        destinationBusesOffsets.forEach((destinationBus, destinationOffsets) -> {
            DestinationBusDescriptor descriptor = destinationBusDescriptors.computeIfAbsent(destinationBus, p -> new DestinationBusDescriptor());
            if (destinationOffsets.size() > 1) {
                // interconnected Bus pins
                destinationBusDescriptors.remove(destinationBus);
                long interconnectMask = 0;
                for (Byte offset : destinationOffsets) {
                    interconnectMask |= (1L << offset);
                }
                Byte offset = destinationOffsets.getFirst();
                destinationOffsets.clear();
                destinationOffsets.add(offset);
                BusInInterconnect interconnect = new BusInInterconnect(destinationBus, interconnectMask, offset);
                destinationBusDescriptors.put(interconnect, descriptor);
            }
            if (TRUE == powerState) {
                SchemaPart pwr = getSchemaPart("Power", "pwr_" + destinationBus.getName(), "hi;strong");
                schemaParts.put(pwr.id, pwr);
                descriptor.add(pwr.getOutItem("OUT"), (byte) 0, destinationOffsets.getFirst());
                sourcesOffset.put(pwr.getOutItem("OUT"), (byte) 0);
            } else if (FALSE == powerState) {
                SchemaPart gnd = getSchemaPart("Power", "gnd_" + destinationBus.getName(), "strong");
                schemaParts.put(gnd.id, gnd);
                descriptor.add(gnd.getOutItem("OUT"), (byte) 0, destinationOffsets.getFirst());
            } else {
                sourcesOffset.forEach((source, sourceOffset) -> descriptor.add(source, sourceOffset, destinationOffsets.getFirst()));
            }
            passivePins.forEach(passivePin -> descriptor.add(passivePin, (byte) 0, destinationOffsets.getFirst()));
        });
    }

    private void buildBuses() {
        //wire destinations
        destinationWireDescriptors.forEach((destination, descriptor) -> processWire(destination, descriptor.pins, descriptor.passivePins, descriptor.buses));
        //Bus destinations
        destinationBusDescriptors.forEach((destination, descriptor) -> {
            descriptor.cleanBuses();
            if (descriptor.useBusMerger()) {
                //connect destination to multiple sources throe Merger
                String busMergerHash = Utils.getHash(descriptor.offsets.values()
                                .stream().flatMap(i -> i.pins.stream()).toList(),
                        descriptor.offsets.values()
                                .stream().flatMap(i -> i.passivePins.stream()).toList(),
                        descriptor.buses.keySet());
                if (busMergers.containsKey(busMergerHash)) {
                    //just connect to already created bus merger
                    busMergers.get(busMergerHash).addDestination(destination);
                } else {
                    //create new one bus merger
                    BusMerger busMerger = new BusMerger(destination);
                    //add all pins
                    descriptor.offsets.forEach((offset, lists) -> {
                        //search already processed wires
                        String passiveHash = Utils.getHash(lists.passivePins);
                        if (wires.containsKey(passiveHash)) {
                            //if found by passive pins - connect it and don't process further
                            busMerger.addSource(wires.get(passiveHash), offset);
                        } else {
                            String wireHash = Utils.getHash(lists.pins);
                            if (wires.containsKey(wireHash)) {
                                //if found by usual pins (complete wire merger) - connect it and don't process further
                                busMerger.addSource(wires.get(wireHash), offset);
                            } else {
                                //process unprocessed wire
                                busMerger.addSource(Model.this, lists.pins, lists.passivePins, offset);
                            }
                        }
                    });
                    //add all buses
                    descriptor.buses.forEach((source, offsets) -> offsets.forEach((offset, mask) -> busMerger.addSource(source, mask, offset)));
                    busMergers.put(busMergerHash, busMerger);
                }
            } else {
                //use direct connect to destination
                if (descriptor.buses.isEmpty()) {
                    //pin-to-bus
                    //search if wire already processed
                    descriptor.offsets.forEach((offset, lists) -> {
                        //search already processed wires
                        String passiveHash = Utils.getHash(lists.passivePins);
                        if (wires.containsKey(passiveHash)) {
                            //if found by passive pins - connect it and don't process further
                            wires.get(passiveHash).addDestination(destination, offset);
                        } else {
                            String wireHash = Utils.getHash(lists.pins);
                            if (wires.containsKey(wireHash)) {
                                //if found by usual pins (complete wire merger) - connect it and don't process further
                                wires.get(wireHash).addDestination(destination, offset);
                            } else {
                                //process unprocessed wire
                                if (lists.pins.size() > 1) {
                                    //use wire merger
                                    processWire(new WireToBusAdapter(destination, offset), lists.pins, lists.passivePins, null);
                                } else {
                                    //use direct wire connect
                                    lists.pins.getFirst().addDestination(destination, offset);
                                }
                            }
                        }
                    });
                } else {
                    //bus-to-bus connection
                    descriptor.buses.forEach((source, offsetMap) -> offsetMap.forEach((offset, mask) -> source.addDestination(destination, mask, offset)));
                }
            }
        });
        for (SchemaPart p : schemaParts.values()) {
            for (IModelItem<?> outItem : p.outPins.values()
                    .stream().distinct().toList()) {
                replaceOut(outItem);
            }
        }
    }

    private void replaceOut(IModelItem<?> outItem) {
        outItem.getParent().replaceOut(outItem);
    }

    private void createSchemaPart(Comp component, SchemaPartMap map) {
        SymbolDesc symbolDesc = null;
        if (map != null) {
            SymbolLibMap lib = map.libs.get(component.getLibsource().getLib());
            if (lib != null) {
                symbolDesc = lib.symbols.get(component.getLibsource().getPart());
            }
        }
        String id = component.getRef();
        String className = findSchemaPartProperty(component, "SymPartClass");
        if ((className == null || className.isBlank()) && symbolDesc != null) {
            className = symbolDesc.clazz;
        }
        if (className == null || className.isBlank()) {
            throw new RuntimeException("SchemaPart " + id + " has no parameter SymPartClass");
        }
        String parameters = "";
        if (symbolDesc != null && symbolDesc.params != null && !symbolDesc.params.isBlank()) {
            parameters += symbolDesc.params + ";";
        }
        parameters += findSchemaPartProperty(component, "SymPartParam");
        if (symbolDesc == null || symbolDesc.units == null) {
            SchemaPart schemaPart = getSchemaPart(className, id, parameters);
            schemaParts.put(schemaPart.id, schemaPart);
        } else {
            for (int i = 0; i < symbolDesc.units.size(); i++) {
                String unit = symbolDesc.units.get(i);
                String name;
                if (symbolDesc.units.size() == 1) {
                    name = id;
                } else {
                    name = id + "_" + (char) (((byte) 'A') + i);
                }
                SchemaPart schemaPart = getSchemaPart(className, name, parameters);
                schemaParts.put(schemaPart.id, schemaPart);
                for (String pinMapInfo : unit.split(";")) {
                    String[] mapInfo = pinMapInfo.split("=");
                    schemaPartPinMap.computeIfAbsent(id, s -> new HashMap<>()).put(mapInfo[0], new PinMapDescriptor(mapInfo[1], schemaPart));
                }
            }
        }
    }

    private SchemaPart getSchemaPart(String className, String id, String params) {
        if (!schemaPartSpiMap.containsKey(className)) {
            throw new RuntimeException("Unknown SchemaPart class " + className + " for SchemaPart id " + id);
        }
        SchemaPart schemaPart = schemaPartSpiMap.get(className).getSchemaPart(id, params);
        if (schemaPart == null) {
            throw new RuntimeException("SchemaPart " + id + " parameter SymPartClass doesn't reflect AbstractSchemaPart class");
        }
        return schemaPart;
    }

    private String findSchemaPartProperty(Comp component, String name) {
        if (component.getProperty() != null) {
            for (Property property : component.getProperty()) {
                if (property.getName().equals(name)) {
                    return property.getValue();
                }
            }
        }
        return "";
    }

    private void stabilise() {
        stabilizing = true;
        schemaParts.values()
                .stream()
                .flatMap(p -> p.outPins.values()
                        .stream())
                .filter(i -> !i.isHiImpedance())
                .distinct()
                .forEach(item -> {
                    assert Log.debug(Model.class, "Resend pin {}", item);
                    item.resend();
                    resend();
                });
        schemaParts.values()
                .stream()
                .flatMap(p -> p.passivePins.values()
                        .stream())
                .filter(ModelItem::isHiImpedance)
                .distinct()
                .forEach(item -> {
                    assert Log.debug(Model.class, "Resend pin {}", item);
                    item.resend();
                    resend();
                });
        schemaParts.values().forEach(SchemaPart::reset);
        stabilizing = false;
    }

    private void resend() {
        ArrayList<IModelItem<?>> items = new ArrayList<>(forResend);
        forResend.clear();
        items.forEach(item -> {
            assert Log.debug(Model.class, "Resend postponed pin {}", item);
            item.resend();
        });
    }

    private static class BusPinsOffset {
        public List<OutPin> pins = new ArrayList<>();
        public List<PassivePin> passivePins = new ArrayList<>();
    }

    public static class DestinationWireDescriptor {
        //Bus, offset
        public final HashMap<OutBus, Long> buses = new HashMap<>();
        //Pin, offset
        public final List<OutPin> pins = new ArrayList<>();
        public final List<PassivePin> passivePins;

        public DestinationWireDescriptor(List<PassivePin> passivePins) {
            this.passivePins = passivePins;
        }

        public void add(IModelItem<?> item, byte offset) {
            switch (item) {
                case OutPin pin -> pins.add(pin);
                case OutBus bus -> buses.put(bus, 1L << offset);
                default -> throw new IllegalStateException("Unsupported item: " + item.getClass().getName());
            }
        }
    }

    private class DestinationBusDescriptor {
        //Bus, offset, mask
        public HashMap<OutBus, Map<Byte, Long>> buses = new HashMap<>();
        //Pin, offset
        public HashMap<Byte, BusPinsOffset> offsets = new HashMap<>();

        public boolean useBusMerger() {
            return buses.values()
                    .stream().mapToLong(Map::size).sum() + offsets.values().size() > 1;
        }

        public void add(IModelItem<?> item, byte sourceOffset, byte destinationOffset) {
            switch (item) {
                case PassivePin passivePin -> offsets.computeIfAbsent(destinationOffset, e -> new BusPinsOffset()).passivePins.add(passivePin);
                case OutPin pin -> offsets.computeIfAbsent(destinationOffset, e -> new BusPinsOffset()).pins.add(pin);
                case OutBus bus -> {
                    byte offset = (byte) (destinationOffset - sourceOffset);
                    long newMask = buses.computeIfAbsent(bus, p -> new HashMap<>()).computeIfAbsent(offset, p -> 0L) | (1L << sourceOffset);
                    buses.get(bus).put(offset, newMask);
                }
                default -> throw new IllegalStateException("Unsupported item: " + item.getClass().getName());
            }
        }

        public void cleanBuses() {
            offsets.forEach((pinsOffset, lists) -> {
                if (lists.passivePins.stream().allMatch(p -> p.source != null)) {
                    //clean up all buses mask
                    buses.values()
                            .stream()
                            .flatMap(m -> m.entrySet()
                                    .stream())
                            .filter(o -> o.getKey() <= pinsOffset)
                            .forEach(pair -> {
                                long correctedMask = ~(1L << (pinsOffset - pair.getKey()));
                                pair.setValue(pair.getValue() & correctedMask);
                            });
                    //remove empty offsets
                    buses.values().forEach(map -> map.entrySet().removeIf(entry -> entry.getValue() == 0));
                    buses.entrySet().removeIf(entry -> entry.getValue().isEmpty());
                }
            });
        }
    }
}
