kopavel/KiCadLogicalSchemeSimulator/simulator/src/java/pko/KiCadLogicalSchemeSimulator/optimiser/JavaCompiler.java

/*
 *
 *  * Copyright (C) 2024 Pavel Korzh
 *  * SPDX-License-Identifier: GPL-3.0-only
 *
 */
package pko.KiCadLogicalSchemeSimulator.optimiser;
import lombok.Getter;
import lombok.Lombok;
import org.apache.logging.log4j.Logger;
import pko.KiCadLogicalSchemeSimulator.Simulator;
import pko.KiCadLogicalSchemeSimulator.tools.Log;

import javax.tools.*;
import javax.tools.JavaCompiler.CompilationTask;
import javax.tools.JavaFileObject.Kind;
import java.io.*;
import java.net.URI;
import java.nio.file.Files;
import java.nio.file.Paths;
import java.util.*;
import java.util.Map.Entry;

public enum JavaCompiler {
    ;
    private static final javax.tools.JavaCompiler compiler;
    private static final List<String> optionList;
    private static final DynamicClassLoader classLoader = new DynamicClassLoader(ClassLoader.getSystemClassLoader());
    private static final List<Diagnostic<? extends JavaFileObject>> diagnosticsList = new ArrayList<>();
    private static final InMemoryJavaFileManager fileManager;
    static {
        try {
            compiler = ToolProvider.getSystemJavaCompiler();
            if (compiler == null) {
                throw new IllegalStateException("No Java compiler available");
            }
            String path = JavaCompiler.class.getProtectionDomain().getCodeSource().getLocation().getFile();
            boolean win = System.getProperty("os.name").toLowerCase().contains("win");
            if (win && !path.isEmpty() && path.charAt(0) == '/') {
                path = path.substring(1);
            }
            StringBuilder paths = new StringBuilder(path);
            if (win) {
                paths.append(";").append(Lombok.class.getProtectionDomain().getCodeSource().getLocation().getFile().substring(1));
                paths.append(";").append(Logger.class.getProtectionDomain().getCodeSource().getLocation().getFile().substring(1));
            } else {
                paths.append(":").append(Lombok.class.getProtectionDomain().getCodeSource().getLocation().getFile());
                paths.append(":").append(Logger.class.getProtectionDomain().getCodeSource().getLocation().getFile());
            }
            Simulator.schemaPartSpiMap.values().forEach(spi -> {
                String spiPath = spi.getClass().getProtectionDomain().getCodeSource().getLocation().getFile();
                if (win && !spiPath.isEmpty() && spiPath.charAt(0) == '/') {
                    spiPath = spiPath.substring(1);
                }
                paths.append(win ? ";" : ":").append(spiPath);
            });
            Log.debug(JavaCompiler.class, "Use class path for compiler: {}", paths);
            optionList = new ArrayList<>();
            optionList.add("-Xlint:none");
            optionList.add("-cp");
            optionList.add(paths.toString());
            optionList.add("-g");
            optionList.add("-proc:full");
            fileManager = new InMemoryJavaFileManager(compiler.getStandardFileManager(null, null, null));
        } catch (Exception e) {
            throw new RuntimeException(e);
        }
    }
    public static Class<?> compileJavaSource(String classPath, String className, String sourceCode) {
        fileManager.getClassBytes().clear();
        diagnosticsList.clear();
        if (performCompilation(className, sourceCode)) {
            return loadCompiledClasses(classPath);
        } else {
            reportCompilationErrors();
            return null;
        }
    }

    private static boolean performCompilation(String className, String sourceCode) {
        JavaFileObject javaFileObject = new InMemoryJavaFileObject(className, sourceCode);
        List<JavaFileObject> javaFileObjects = Collections.singletonList(javaFileObject);
        CompilationTask task = compiler.getTask(null, fileManager, diagnosticsList::add, optionList, null, javaFileObjects);
        return task.call();
    }

    private static Class<?> loadCompiledClasses(String classPath) {
        Class<?>[] retClass = new Class[1];
        fileManager.getClassBytes().entrySet()
                .stream()
                .filter(e -> e.getKey().contains(".optimised.")).sorted(Entry.<String, ByteArrayOutputStream>comparingByKey().reversed()).forEach(entry -> {
                       try {
                           try {
                               Class.forName(entry.getKey());
                               Log.warn(JavaCompiler.class, "Class {} already loaded", entry.getKey());
                           } catch (ClassNotFoundException ignore) {
                               Log.debug(JavaCompiler.class, "Cache and load dynamically optimised class {}", entry.getKey());
                               byte[] classBytes = entry.getValue().toByteArray();
                               storeClass(entry.getKey(), classBytes);
                               retClass[0] = classLoader.defineClassInPackage(classPath, classBytes);
                           }
                       } catch (Exception e) {
                           throw new RuntimeException(e);
                       }
                   });
        return retClass[0];
    }

    private static void reportCompilationErrors() {
        Log.error(JavaCompiler.class, "Can't compile source");
        for (Diagnostic<? extends JavaFileObject> diagnostic : diagnosticsList) {
            if (diagnostic.getPosition() >= 0) {
                Log.error(JavaCompiler.class,
                        "{} at {}:{} {} \n   {}",
                        diagnostic.getKind(),
                        diagnostic.getLineNumber(),
                        diagnostic.getColumnNumber(),
                        diagnostic.getSource().getName(),
                        diagnostic.getMessage(Locale.getDefault()));
            } else {
                Log.error(JavaCompiler.class, "{}: {}", diagnostic.getKind(), diagnostic.getMessage(Locale.getDefault()));
            }
        }
    }

    private static void storeClass(String className, byte[] byteArray) {
        Thread.ofVirtual().start(() -> {
            String path = Simulator.optimisedDir + File.separator + className.replace(".", File.separator) + ".class";
            String dirPath = path.substring(0, path.lastIndexOf(File.separator));
            try {
                Files.createDirectories(Paths.get(dirPath));
                try (OutputStream os = new BufferedOutputStream(new FileOutputStream(path))) {
                    os.write(byteArray);
                }
            } catch (IOException e) {
                throw new RuntimeException(e);
            }
        });
    }

    static class InMemoryJavaFileObject extends SimpleJavaFileObject {
        private final String sourceCode;

        protected InMemoryJavaFileObject(String className, String sourceCode) {
            super(URI.create("string:///" + className.replace('.', '/') + Kind.SOURCE.extension), Kind.SOURCE);
            this.sourceCode = sourceCode;
        }

        @Override
        public CharSequence getCharContent(boolean ignoreEncodingErrors) {
            return sourceCode;
        }
    }

    @Getter
    static class InMemoryJavaFileManager extends ForwardingJavaFileManager<JavaFileManager> {
        private final Map<String, ByteArrayOutputStream> classBytes = new HashMap<>();

        InMemoryJavaFileManager(JavaFileManager fileManager) {
            super(fileManager);
        }

        @Override
        public JavaFileObject getJavaFileForOutput(Location location, String className, Kind kind, FileObject sibling) {
            ByteArrayOutputStream outputStream = new ByteArrayOutputStream();
            classBytes.put(className, outputStream);
            return new SimpleJavaFileObject(URI.create("file:///" + className.replace('.', '/') + kind.extension), kind) {
                @Override
                public OutputStream openOutputStream() {
                    return outputStream;
                }
            };
        }
    }
}
