kopavel/KiCadLogicalSchemeSimulator/(commit log)

2024-04-27 input pin interconnection multy unit KiCad symbols support chip -> schema part (not all parts are chips)
2024-05-02 reintroduce oscilloscope
    [counters.kicad_sch]
2024-05-17 reintroduce switch, fix DCounter
    [DcTrigger.java, JkTrigger.java]
2024-05-29 revert "weak" signal support from model - switch cant be implemented in such way... switch doesn't work
    [DcTrigger.java]
2024-05-31 Reimplement Z80 core in IoQueue/callback manner. Eliminate separate thread for core and "busy/wait" synchronization with it. Reduce component latency and CPU utilization by 100% on one core.
2024-06-02 inPin.rawState/outPin.state -> pin.state
2024-06-21 Johnson counter unittest (Hi CarryIn case)
2024-06-21 fixes for KiCad8
2024-06-26 check out pin change on schemaPart side - it's faster
2024-07-05 strength in models
    [switch.kicad_sch]
2024-07-07 pre V2 commit
    [switch.kicad_sch]
2024-07-12 new API: Model build/optimization fixes Start migrate schema part to new API (Oscillator, Counter, Power, Led)
2024-07-13 polish new API: Add variantId (for easier debugging) Migrate schema parts to new API (Decoder, Switch)
2024-07-14 new API: Bus/Pin mergers
2024-07-17 new API: Model/Builder fixes
    [Model.java]
2024-07-21 Passive Pin support in a model. Package naming/refactoring Partial old api cleanup/delete
2024-07-22 Switch on passivePin Model build fixes
    [Model.java]
2024-07-22 safer state transfer in case when chip out connected to chip in.
2024-07-22 Migrate schema parts to new API (Display, fixes)
    [DcTrigger.java]
2024-07-24 Model fixes - at least Z80 schema can stabilize ...
    [DcTrigger.java]
2024-07-26 Model fixes - Z80 schema give first symptoms of life...
    [DcTrigger.java, Model.java]
2024-07-27 Model/model build fixes. model item id naming tune for better debug
    [Model.java]
2024-07-27 Fix similar WireMerger to BusMerger binding.
    [Model.java]
2024-07-31 Model building/optimisation was messy - rework it completely...
    [switch.kicad_sch]
2024-07-31 Model building/optimisation fixes (z80 work now, again)
    [Model.java]
2024-08-02 Migrate schema parts to new API (JkTrigger, fixes)
    [DcTrigger.java, JkTrigger.java]
2024-08-03 implement pull resisters with passive pin. different approach in model stabilisation
    [switch.kicad_sch]
2024-08-04 model build fixes
    [switch.kicad_sch]
2024-08-05 Introduce pull pin for pull up/down resisters - passive pins are heavier in merging when combined bus and wire ins
    [switch.kicad_sch]
2024-08-11 Revert "DcTrigger tune"
    This reverts commit 91f00881cb281aa3c0d4dd64a9f923d0e2ef325b.
    [DcTrigger.java]
2024-08-11 cleanup BusInterconnect optimise fix generated Class Name fix
    [switch.kicad_sch]
2024-08-11 - some fixme
    [switch.kicad_sch]
2024-08-12 - fixme Catch compile errors from optimiser and just log it, don't fail - use generic implementation instead.
    [JavaCompiler.java]
2024-08-12 more Optimiser in WireMerger inputs
2024-08-12 tune Optimiser in WireMerger inputs
2024-08-13 Oscillator Enter frequency instead of period. Hold target frequency more precise. Show achieved frequency in desc. Readme
    [counters.kicad_sch]
2024-08-14 fix - Schema part monitor: OUT stuck in Hi
    [DcTrigger.java]
2024-08-14 preserve asserts in generated class if asserts are enabled Optimiser for schema part pins use Optimiser in SwitchPin.
2024-08-18 passive pin redesign
2024-08-20 Switch Partial passive pin logic fix
    [Net.java]
2024-08-21 Partial passive pin logic fix
2024-08-21 Switch seems to work
2024-08-22 Optimiser on Wire merger INs
2024-08-23 Introduce “Net Tester” for Unit Tests. Actualise unit test for And/Or/Buffer.
    [Or.kicad_sch, and.kicad_sch, buffer.kicad_sch]
2024-08-24 Actualise unit test for Counter
    [counter.kicad_sch]
2024-08-24 Actualise unit test for dCounter
    [counter.kicad_sch, dCounter.kicad_sch]
2024-08-24 Actualise unit test for dcTrigger, fix mapping for 4013
    [dcTrigger.kicad_sch]
2024-08-26 Actualise unit test for decoder
    [decoder.kicad_sch]
2024-08-26 Fix jkTrigger Actualise unit test for jkTrigger
    [jkTrigger.kicad_sch]
2024-08-26 Fix JnCounter and mapping for it. Actualise unit test for JnCounter.
    [jnCounter.kicad_sch]
2024-08-26 Take offsets in bus merger hash function. Actualise unit test for Merger.
    [multiplexer.kicad_sch]
2024-08-26 race condition in “Display” size setting
2024-08-26 Fix RAM A bus change in reverse mode. Unit test for RAM.
    [ram.kicad_sch]
2024-08-26 Unit test for NOT/Repeater.
    [repeater.kicad_sch]
2024-08-26 cleanup. Rom unit test.
    [rom.kicad_sch]
2024-08-26 Extend RAM unit test SdRam unit test.
    [sdRam.kicad_sch]
2024-08-27 Cleanup. Shifter unit test.
    [shifter.kicad_sch]
2024-08-27 Fix 4056 mapping. StateMachine unit test.
    [state.kicad_sch]
2024-08-28 fix wire merger wire in
2024-08-28 “Display” size setting race condition (again). Optimise or/and gates.
2024-08-28 Switch unit test
    [switch.kicad_sch]
2024-08-28 Xor gate unit test
    [xor.kicad_sch]
2024-08-29 more robust Switch logic
2024-08-29 tune Switch
2024-08-30 Introduce Diode. Diode unit test. Partial Map of KiCad diodes (there to many for complete mapping — may be later)
2024-08-30 Introduce Diode. Diode unit test. Partial Map of KiCad diodes (there to many for complete mapping — may be later) Readme for Diode and Switch.
    [diode.kicad_sch]
2024-08-30 Introduce BusDriver. Map 74LS367.
    [busDriver.kicad_sch]
2024-08-31 Decoder with multiple output pin groups. Mapping for 74LS156.
    [MultiOutDecoder.kicad_sch]
2024-08-31 Add OE pin to multiplexer. Mapping for 74LS157 and Memory_EPROM/2764
2024-09-02 MultiUnitCounter Mapping for 74LS92
    [MultiUnitCounter.kicad_sch]
2024-09-03 Masked multiplexer Map 74LS157, 74LS153
    [maskedMultiplexer.kicad_sch, multiplexer.kicad_sch]
2024-09-11 fix Lombok usage in Optimised class
    [JavaCompiler.java]
2024-09-11 Floating pin are not good but possible state - remove FloatingIn exception
2024-09-15 fix Net with bus pin interconnect building.
    [Net.java]
2024-09-16 reset parts after stabilising complete and do multiple times because of hierarchical update.
    [Net.java]
2024-09-17 fix oscillator "multiple thread start" in case of "start" parameter
    [Net.java]
2024-09-18 fix bus merger wire in
2024-09-18 fix DC trigger in case of floating RS pins
    [DcTrigger.java]
2024-09-18 fill RAM/SDRAM with random content on "power on"
2024-09-22 NEt build fix in case of multiple power pins and multiple interconnectors on bus.
    [Net.java]
2024-09-23 fix busMerger in case of recurse
2024-09-24 Display — fix array index out of bound on stabilising.
2024-09-26 drop impedance for better logging in case of shortcut
2024-09-26 Class optimiser — separate `ea` and `non-ea` optimised classes
2024-09-26 set state in oscilloscope pin
2024-09-27 Optimiser — LOG source file name in case of error
2024-09-27 no such thing, like wire to bus — this always connected throe merger.
2024-09-27 Optimiser: if cut whole f-ion — next function remain. Fix.
2024-09-28 OscillatorUi - on form open divide entered freq by 1000 — fix.
2024-09-29 Gradle tasks for examples new “TRS80” example
    [TRS80I.kicad_sch]
2024-09-30 -TODO (Passive pin is "tri-state”. Ignore setImpedance from it to power rail)
2024-09-30 map "power pins"
2024-10-01 JavaCompiler — add logger to classpath
2024-10-01 Revert 2317de7e. Benchmark show — direct constant always win compared to final variable.
2024-10-01 Revert 2317de7e. Benchmark show — direct constant always win compared to final variable. (some remains)
2024-10-02 Unify formating of schema parts readme (Bus driver, Counter, Multipart counter).
    [MultiPartCounter.kicad_sch]
2024-10-03 New parameters for CLI: — rd for disable recurse support completely. — do for disable code optimiser. Map fix for power units. Java compiler — fix with "no-code" errors. FullOptimiser support in Offs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
    [JavaCompiler.java, Net.java]
2024-10-03 tune Led, Repeater
2024-10-04 Fix dynamic class loading in Optimiser for usage in schema parts. Use optimiser in counter.
    [JavaCompiler.java, Simulator.java]
2024-10-05 Fis RS pins in DCTrigger Use Optimiser for DCTrigger pins in case of no R/S pins
    [TRS80I.kicad_sch]
2024-10-05 More Optimiser for DCTrigger C pin
2024-10-06 Java compiler: if class not loaded but used by optimised class - javac return it in “compiled” list — skip it.
    [JavaCompiler.java]
2024-10-08 fix 74LS92 (It's not divider by 16, but rather by 12). Other fixes.
    [TRS80I.kicad_sch]
2024-10-12 Unify Schema parts readme formatting (Diode, Display, JkTrigger, RingCounter). 4017 and 4022 and NOT `Johnson` but rather `Ring` counters.
    [jnCounter.kicad_sch]
2024-10-12 Fix unit test executing. Fix RS pins in DC trigger.
    [DcRPin.java, DcSPin.java]
2024-10-13 Fix UnitTest for MultiPart Counter. Fixes in MultiPart Counter.
    [MultiPartCounter.kicad_sch]
2024-10-13 4017 and 4022 and NOT `Johnson` but rather `Ring` counters. (fix package name)
    [ringCounter.kicad_sch]
2024-10-14 Expand wire API
    [TRS80I.kicad_sch]
2024-10-15 Fix DCTrigger, fix optimisers things
    [DcCPin.java, DcRPin.java, DcSPin.java]
2024-10-15 fix WireMergerBusIn
2024-10-16 Unify Schema parts readme formatting (Keyboard, Led, Multiplexer)
2024-10-17 tune Z80 pin layer.
2024-10-18 Unify Schema parts readme formatting (Power, Ram, SingleBitRam)
2024-10-19 Unify Schema parts readme formatting. (Xor, Switch, Z80). Spelling: Lo -> Low.
2024-10-20 Support multiple unrolls in Optimiser. Reintroduce 'Edge' pins allowing optimisation in 'destinations' iterators. Use Edge pin optimisation in OutPin.
2024-10-21 fix Pin naming in SchemaPartMonitor
    [Simulator.java]
2024-10-21 Group oscilloscope pin selection menu by SchemaParts.
2024-10-22 Oscilloscope. "in"/"out" labels in pin select menu are JLabel, not JMeniItem.
2024-10-25 Z80Cpu - make C pin external and move all CPU pins inside as local variables.
2024-10-27 Fix MultipartCounter Optimiser (nonReverse case and max count reset).
2024-10-27 Fix NPE. (Introduce params file for a schema.)
    [Net.java]
2024-12-23 Low latency async consumer. Volatile → AtomicReference,
2024-12-28 Reduce GC pressure from lambdas.
2024-12-29 `16-segment LED Display` schema part. Map Display_Character:HDSP-A153.
2024-12-29 `16-segment LED Display` schema part. (README)
2024-12-29 `16-segment LED Display` schema part. (README path)
2024-12-30 tune Oscillator for low frequencies (couple of hertz)
2024-12-30 "7 segment led display" schema part
2024-12-30 Mergers destination source setting fix
    [Simulator.java]
2024-12-30 Clock example.
    [clock.kicad_sch]
2024-12-30 if no map file specified nor in CLI params nor in a schema param file - use at least `KiCad` map file.
2025-01-01 BatchedAsyncConsumer fast, but not enough…
2025-01-02 clock example - blinking second point.
    [clock.kicad_sch]
2025-02-17 OR/ANG gates tune. Z80 C pin tune
2025-03-15 preserve ignored units in Schema part instance from mapping file
    [clock.kicad_sch]
2025-03-15 fix default map file name
    [Simulator.java]
2025-03-15 fix Passive pin logic
    [Net.java]
2025-03-16 Implement simple Resister
    [resister.kicad_sch]
2025-03-16 Introduce NetFilters. Implement "Resister to PullResister" Net filter.
    [resister.kicad_sch]
2025-03-17 implement Dip Switch behaviour using Net file filter.
    [dipSwitch.kicad_sch]
2025-03-19 WireMerger - fix false shortcut detection
2025-03-19 powerState from ParameterResolver
2025-03-19 fix map file search in working dir
    [Simulator.java]
2025-03-19 more info on error
    [Net.java]
2025-03-20 preserve 'source' after 'IN' pin optimisation.
2025-03-22 pin events processing priority
2025-03-23 DimSwitch filter fix with multiple DIP on one NET
    [dipSwitch.kicad_sch]
2025-03-25 MultiOutDecoder - pin based
2025-03-25 WireMergerWireIn fix
2025-03-25 error on bus shortcut
    [Net.java]
2025-03-26 MCM6670 map fix
    [TRS80I.kicad_sch]
2025-04-05 repeat filters until no one make modification.
2025-04-07 SchemaPartMonitor - fix out pin order
2025-04-08 fis ClassOptimiser in case of multiples unroll
2025-04-12 SchemaPart - Tri-state pin pinType setting fix
2025-04-12 Net - more info on error
    [Net.java]
2025-04-12 Fix MOS 6502 Logic and simple example. Readme
    [mos6502.kicad_sch]
2025-04-13 BusDriver/Rom - CS pin priority
2025-04-13 Mos6532 - fix logic.
    [Mos6532.java]
2025-04-13 Mos6502 - fix logic.
    [mos6502.kicad_sch]
2025-04-13 Mos6502 - print Extra state
2025-04-13 Mos6502 - fix in "print Extra state"
2025-04-13 Mos6502/6532 - fix IRQ routines
    [Mos6532.java]
2025-04-13 Mos6502/6532 - example
    [mos6502.kicad_sch]
2025-04-25 replaceIn fix in Bus case
2025-04-25 Rom - cs pin initial state fix
2025-04-25 fix tri-state preservation for in/out
    [JavaCompiler.java]
2025-05-02 WireMergerBusIn implement SupportMask
2025-05-02 fix Passive pin event recursion
2025-05-02 SingleOutShifterCIPin - fix InhibitClock/Reverse pin logic.
2025-05-03 MultiOutDecoder - Optimiser, Complete Reverse/OpenCollector suppor, Unittest Fix. Decodes - simplify.
    [MultiOutDecoder.kicad_sch]
2025-05-04 Multipart Counter optimised R pin compile fix
2025-05-04 WireMerger initial impedance state and triStateOut fix
2025-05-04 Bench "Byte Code manipulation" - JIT do it pretty well by itself. Cut it out.
    [byteCode.kicad_sch]
2025-05-04 OrGate benchmark/tune.
    [byteCode.kicad_sch]
2025-05-06 BusToWiresAdapter bench
    [netBench.kicad_sch]
2025-05-13 PassivePin rework, again. Now it is more optimisation capable. Simpler API/logic. Potentially faster.
    [Net.java]
2025-05-13 PassivePin rework - fix Diode.
2025-05-13 PassivePin rework - fix Resister.
2025-05-13 PassivePin rework - fix Switch.
2025-05-27 Always propagate merger change to passive pin.
2025-06-01 Full "diode like" LED implementation.
2025-06-01 Fixes in Switch, Diode
2025-06-02 LED -> LedIndicator filter
    [filters.kicad_sch]
2025-06-02 Fix NPE in LedIndicator filter.
2025-06-02 Net merger helper in for NetFilter. ResisterOnLedIndicatorFilter.
2025-06-02 ResisterOnLedIndicatorFilter -> ResisterFilter. More generic filter: if resister on Input only and other out is weak - shortcut it.
2025-06-12 fix ResisterFilter
2025-06-16 Transistor filter (uncompleted)
    [filters.kicad_sch]
2025-06-17 ResisterFilter - ignore current Node (resister himself) calculating decision.
2025-06-17 Transistor filter
2025-06-29 Add dynamic inertia to LEDSegmentDisplays.
2025-06-29 LED7SegmentDisplays: - CS pin for a common anode/cathode. - pdLeft parameter for dot on left side. MAN72A and 74LS138 mapping.
2026-02-19 Passive pin fix and test adjustments
    [Net.java]
2026-04-10 JavaCompiller: fix class-pass build for Linux
    [JavaCompiler.java]
2026-04-13 Led7Segment enabled if no CS pin is configured
2026-04-13 Fix Rom multi CS pin logic.
2026-04-15 Gradle 9.4.1 -> FIX assemble
2026-04-15 Oscilloscope: fix scroll on small sizes. fix load/store, when clock pin is 'in', not 'out'. label is with partId.
2026-04-16 LedIndicator off at highImpedance
2026-04-16 Transistor filter fix
    [filters.kicad_sch]
2026-04-16 WireMergerWireIn source setting fix
2026-04-17 passive case mergers fix.
2026-04-21 better ShortcutException message format
    [JavaCompiler.java]
2026-04-21 extend Pin API
2026-04-28 DisplayUiComponent: reduce GC pressure
2026-05-03 Led7SegmentDisplayEnabledPin is tristate
2026-05-07 6532: reSet OUTs on direction change
    [Mos6532.java]
2026-05-10 Don't throw ShortcutException immediately - try resend state later.
    [Net.java]
2026-05-10 Led7SegmentDisplay: fix/tune 'inertia' logic
2026-05-13 Don't throw ShortcutException immediately - try resend state later. (tune logic). +some 'optimiser' FixMe setting pin strength
    [Net.java]
2026-05-13 Fix buffer capacity calculation
2026-05-27 if no oscillator (pure interactive circuit), create thread/loop for event resend. recalculate passive pins after merger "init".
    [Net.java]
2026-05-28 drop hiImpedance state in case of optimizin-out tristate logic. Other fixes
2026-06-02 fix Switch
2026-06-10 passive pin merge fix
    [diodes.kicad_sch]
2026-08-24 start migrate to SPOCK test framework
    [and.kicad_sch]
2026-08-24 start migrate to SPOCK test framework (Buffer/Latch)
    [buffer.kicad_sch]
2026-08-24 migrate to SPOCK test framework (busDriver)
    [busDriver.kicad_sch]
2026-08-24 SPOCK test framework - more helpers
2026-08-25 SPOCK test framework - test optimised and non-optimised variants
2026-08-25 SPOCK test framework - SingleBit buffer/latch tests
2026-08-25 SPOCK test framework - fail whole test on optimiser compile error
2026-08-25 counters spock unittest and optimiser fix, readme spelling
    [MultiPartCounter.kicad_sch, counter.kicad_sch]
2026-08-26 fulfill MultiPartCounter test, Spock DCounterTest
    [dCounter.kicad_sch]
2026-08-31 PIN/BUS API architecture design document
2026-09-28 decoder SPOCK unittest, fix RAW and decimal mode.
    [decoder.kicad_sch]
2026-10-04 xOr SPOCK unittest
    [xor.kicad_sch]
2026-10-04 xOr SPOCK unittest (naming) StateMachine SPOCK unittest, fix init state
    [state.kicad_sch]
